SoC-Labs/AHB-QSPI/logical/cache_models/tsmc16/cache_ram.v

module cache_ram #(
    parameter ADDR_W=8
    )(
    input  wire                 CLK,
    input  wire [ADDR_W-1:0]    TAG_ADDR,
    input  wire                 TAG_WE,
    input  wire                 TAG_RD,
    input  wire                 TAG_CS,
    input  wire [10:0]          TAG_WDATA,
    output wire [10:0]          TAG_RDATA,

    input  wire [ADDR_W-1:0]    CLD_ADDR,
    input  wire                 CLD_WE,
    input  wire [3:0]           CLD_RD,
    input  wire [3:0]           CLD_CS,
    input  wire [127:0]         CLD_WDATA,
    output wire [127:0]         CLD_RDATA
);

// ----------------------------------------------------------------------------
// RAM0 Instance for Word index 0
// ----------------------------------------------------------------------------
wire    cs_ram0_word0;
assign  cs_ram0_word0   = CLD_CS[0] & (CLD_WE | CLD_RD[0]);

flash_cache_data data_ram_0_word_0_i (
    .CENY(),
    .GWENY(),
    .AY(),
    .Q(CLD_RDATA[31:0]),
    .SO(),
    .PRDYN(),

    .CLK(CLK),
    .CEN(~cs_ram0_word0),
    .GWEN(~CLD_WE),
    .A(CLD_ADDR),
    .D(CLD_WDATA[31:0]),
    .STOV(1'b0),
    .EMA(3'b011),
    .EMAW(2'b01),
    .EMAS(1'b0),
    .RET1N(1'b1),
    .PGEN(1'b0),
    .TEN(1'b1),
    .TCEN(1'b1),
    .TGWEN(1'b1),
    .TA(8'd0),
    .TD(32'd0),
    .SI(2'b00),
    .SE(1'b0),
    .DFTRAMBYP(1'b0),
    .RET2N(1'b1)
);

// ----------------------------------------------------------------------------
// RAM0 Instance for Word index 1
// ----------------------------------------------------------------------------
wire    cs_ram0_word1;
assign  cs_ram0_word1   = CLD_CS[1] & (CLD_WE | CLD_RD[1]);

flash_cache_data data_ram_0_word_1_i (
    .CENY(),
    .GWENY(),
    .AY(),
    .Q(CLD_RDATA[63:32]),
    .SO(),
    .PRDYN(),

    .CLK(CLK),
    .CEN(~cs_ram0_word1),
    .GWEN(~CLD_WE),
    .A(CLD_ADDR),
    .D(CLD_WDATA[63:32]),
    .STOV(1'b0),
    .EMA(3'b011),
    .EMAW(2'b01),
    .EMAS(1'b0),
    .RET1N(1'b1),
    .PGEN(1'b0),
    .TEN(1'b1),
    .TCEN(1'b1),
    .TGWEN(1'b1),
    .TA(8'd0),
    .TD(32'd0),
    .SI(2'b00),
    .SE(1'b0),
    .DFTRAMBYP(1'b0),
    .RET2N(1'b1)
);

// ----------------------------------------------------------------------------
// RAM0 Instance for Word index 2
// ----------------------------------------------------------------------------
wire    cs_ram0_word2;
assign  cs_ram0_word2   = CLD_CS[2] & (CLD_WE | CLD_RD[2]);

flash_cache_data data_ram_0_word_2_i (
    .CENY(),
    .GWENY(),
    .AY(),
    .Q(CLD_RDATA[95:64]),
    .SO(),
    .PRDYN(),

    .CLK(CLK),
    .CEN(~cs_ram0_word2),
    .GWEN(~CLD_WE),
    .A(CLD_ADDR),
    .D(CLD_WDATA[95:64]),
    .STOV(1'b0),
    .EMA(3'b011),
    .EMAW(2'b01),
    .EMAS(1'b0),
    .RET1N(1'b1),
    .PGEN(1'b0),
    .TEN(1'b1),
    .TCEN(1'b1),
    .TGWEN(1'b1),
    .TA(8'd0),
    .TD(32'd0),
    .SI(2'b00),
    .SE(1'b0),
    .DFTRAMBYP(1'b0),
    .RET2N(1'b1)
);

// ----------------------------------------------------------------------------
// RAM0 Instance for Word index 3
// ----------------------------------------------------------------------------
wire    cs_ram0_word3;
assign  cs_ram0_word3   = CLD_CS[3] & (CLD_WE | CLD_RD[3]);

flash_cache_data data_ram_0_word_3_i (
    .CENY(),
    .GWENY(),
    .AY(),
    .Q(CLD_RDATA[127:96]),
    .SO(),
    .PRDYN(),

    .CLK(CLK),
    .CEN(~cs_ram0_word3),
    .GWEN(~CLD_WE),
    .A(CLD_ADDR),
    .D(CLD_WDATA[127:96]),
    .STOV(1'b0),
    .EMA(3'b011),
    .EMAW(2'b01),
    .EMAS(1'b0),
    .RET1N(1'b1),
    .PGEN(1'b0),
    .TEN(1'b1),
    .TCEN(1'b1),
    .TGWEN(1'b1),
    .TA(8'd0),
    .TD(32'd0),
    .SI(2'b00),
    .SE(1'b0),
    .DFTRAMBYP(1'b0),
    .RET2N(1'b1)
);

// ----------------------------------------------------------------------------
// TAG RAM 0 Instance
// ----------------------------------------------------------------------------
wire    cs_tag0;
assign  cs_tag0         = TAG_CS & (TAG_WE | TAG_RD);

flash_cache_tag tag_ram_0_i (
    .CENY(),
    .GWENY(),
    .AY(),
    .Q(TAG_RDATA),
    .SO(),
    .PRDYN(),

    .CLK(CLK),
    .CEN(~cs_tag0),
    .GWEN(~TAG_WE),
    .A(TAG_ADDR),
    .D(TAG_WDATA),
    .STOV(1'b0),
    .EMA(3'b011),
    .EMAW(2'b01),
    .EMAS(1'b0),
    .RET1N(1'b1),
    .PGEN(1'b0),
    .TEN(1'b1),
    .TCEN(1'b1),
    .TGWEN(1'b1),
    .TA(8'd0),
    .TD(11'd0),
    .SI(2'b00),
    .SE(1'b0),
    .DFTRAMBYP(1'b0),
    .RET2N(1'b1)
);



endmodule
