SoC-Labs/AHB-QSPI/uvm/ahb_qspi/agents/qspi_monitor/qspi_monitor_if.sv

///////////////////////////////////////////////////////////////////////////////
// qspi_monitor_if.sv
///////////////////////////////////////////////////////////////////////////////
// Passive interface for observing the QSPI bus signals.
///////////////////////////////////////////////////////////////////////////////

interface qspi_monitor_if;

  logic       sclk;
  logic       csn;
  logic [3:0] io;      // Directly connected to the bidirectional QSPI_IO bus

endinterface
