SoC-Labs/AHB-QSPI/verif/cocotb/ahb_qspi_tests.py

import logging

from numpy import random

import cocotb
from cocotb.clock import Clock
from cocotb.triggers import Timer, ClockCycles

from cocotbext.ahb import AHBLiteMaster, AHBBus

from SST26VF064B import *
from SST26VF064B import poll_busy_clear, POLL_TIMEOUT_CYCLES, _flash_cmd_byte

QSPI_CONFIG_ADDR = 0x0
CACHE_CONFIG_ADDR = 0x1000

class TB:
    def __init__(self,dut):
        self.dut = dut
        
        self.log = logging.getLogger("cocotb.tb")
        self.log.setLevel(logging.DEBUG)
        self.dut.HRESETn.setimmediatevalue(0)
        cocotb.start_soon(Clock(dut.HCLK, 10, units="ns").start())
        self.config_ahb_master = AHBLiteMaster(AHBBus.from_prefix(dut,"config", optional_signals = {"hsel":"HSEL", "hready_in":"HREADY_IN", "hburst":"HBURST"}), dut.HCLK, dut.HRESETn, 5000)
        self.data_ahb_master = AHBLiteMaster(AHBBus.from_prefix(dut,"data", optional_signals = {"hsel":"HSEL", "hready_in":"HREADY_IN", "hburst":"HBURST"}), dut.HCLK, dut.HRESETn, 5000)

    async def cycle_reset(self):
        await ClockCycles(self.dut.HCLK,1)
        await Timer(time=4.5, units='ns')
        self.dut.HRESETn.setimmediatevalue(0)
        await ClockCycles(self.dut.HCLK,40)
        await Timer(time=4.5, units='ns')
        self.dut.HRESETn.setimmediatevalue(1)
        await ClockCycles(self.dut.HCLK,10)
            

    
async def CACHE_READ(dut,tb):
    data = await tb.data_ahb_master.read(0x00,4)
    return int(data[0]['data'],16)   

@cocotb.test()
async def APB_reg_tests(dut):
    tb = TB(dut)
    await tb.cycle_reset()
    
    tb.log.info("Read ID of QSPI Core")
    PIDR=[0x00, 0x00, 0x00, 0x00, 0x59, 0x16, 0x15, 0x00]
    for i in range(0,8):
        PIDr_temp = await tb.config_ahb_master.read(0xFD0 + i*4,4)
        tb.log.info("PIDR %d = %x",i,int(PIDr_temp[0]['data'],16))
        assert int(PIDr_temp[0]['data'],16) == PIDR[i]
    CIDR=[0x50, 0x51, 0x4C, 0x53]
    for i in range(0,4):
        CIDR_temp = await tb.config_ahb_master.read(0xFF0 + i*4,4)
        tb.log.info("CIDR %d = %x",i,int(CIDR_temp[0]['data'],16))
        assert int(CIDR_temp[0]['data'],16) == CIDR[i]

    tb.log.info("Test REG12")
    await tb.config_ahb_master.write(0x30,0xFFFFFFFF)
    reg12 = await tb.config_ahb_master.read(0x30,4)
    assert int(reg12[0]['data'],16) == 0xFFFFFFFF

    tb.log.info("Test REG0")
    await tb.config_ahb_master.write(0x00,0xFFFFFFFF)
    reg0 = await tb.config_ahb_master.read(0x00,4)
    assert int(reg0[0]['data'],16) == 0xFFFFFFFF

    tb.log.info("Test REG1")
    await tb.config_ahb_master.write(0x04,0xFFFFFFFF)
    reg1 = await tb.config_ahb_master.read(0x04,4)
    reg1 =int(reg1[0]['data'],16)
    reg1 = reg1 | 1
    reg1 = reg1 | (1<<8)
    assert reg1 == 0xFFFFFFFF

    tb.log.info("Test REG2")
    await tb.config_ahb_master.write(0x08,0xFFFFFFFF)
    reg2 = await tb.config_ahb_master.read(0x08,4)
    assert int(reg2[0]['data'],16) == 0xFFFFFFFF

    tb.log.info("Test REG3")
    await tb.config_ahb_master.write(0x0C,0xFFFFFFFF)
    reg3 = await tb.config_ahb_master.read(0x0C,4)
    assert int(reg3[0]['data'],16) == 0xFFFFFFFF


@cocotb.test()
async def QSPI_TESTS(dut):  
    tb = TB(dut)
    await tb.cycle_reset()    
    
    tb.log.info("Reset SPI")
    await SPI_RESET(dut, tb)
    
    tb.log.info("Reading JEDIC in SPI mode")
    
    rID = await SPI_READ_JEDIC(dut, tb)
    tb.log.info("Read ID: 0x%x",rID)
    assert rID == ID
    
    tb.log.info("Setting QPI mode")
    await SET_QPI_MODE(dut, tb)
    await tb.config_ahb_master.write(0x00,0x1)
    
    tb.log.info("Reading JEDIC in QPI mode")
    rID = await QPI_READ_JEDIC(dut, tb)
    tb.log.info("Read ID: 0x%x",rID)
    assert rID == ID

    tb.log.info("Enable Write")
    await SPI_WRITE_ENABLE(dut, tb)
    SPI_STAT = await QPI_READ_STAT_REG(dut, tb)
    WEL = SPI_STAT & (1<<25)
    assert WEL != 0
    
    tb.log.info("Clear Protection and enable Write")
    await SPI_CLR_PROTECTION(dut, tb)
    await SPI_WRITE_ENABLE(dut, tb)
    SPI_STAT = await QPI_READ_STAT_REG(dut, tb)
    WEL = SPI_STAT & (1<<25)
    assert WEL != 0
    
    # Write and read 32-bit word
    tb.log.info("Page program 4x bytes")
    data = [0x18273456]
    await QPI_PAGE_PROGRAM(dut, tb, words=data, n_words=1)
    
    tb.log.info("Read 4x bytes")

    await SPI_WRITE_DISABLE(dut,tb)
    rdata = await QPI_READ_WORDS(dut, tb, n_words=1)
    assert rdata == data
        
    # Write and read 2x 32=bit words
    tb.log.info("Page program 8x bytes")
    data = [0x01234567, 0x89ABCDEF]
    await SPI_WRITE_ENABLE(dut, tb)
    await QPI_PAGE_PROGRAM(dut, tb, addr=0x100, words=data, n_words=2)
    
    tb.log.info("Read 8x bytes")
    await SPI_WRITE_DISABLE(dut,tb)
    rdata = await QPI_READ_WORDS(dut, tb, addr=0x100, n_words=2)
    assert rdata == data

    # Write and read 3x 32=bit words
    tb.log.info("Page program 12x bytes")
    data = [0x13243546, 0x97867564, 0x01234567]
    await SPI_WRITE_ENABLE(dut, tb)
    await QPI_PAGE_PROGRAM(dut, tb, addr=0x200, words=data, n_words=3)
    
    await SPI_WRITE_DISABLE(dut,tb)
    tb.log.info("Read 12x bytes")
    rdata = await QPI_READ_WORDS(dut, tb, addr=0x200, n_words=3)
    assert rdata == data

    # Write and read 4x 32=bit words
    tb.log.info("Page program 16x bytes")
    data = [0x13243546, 0x97867564, 0x89ABCDEF, 0x01234567]
    await SPI_WRITE_ENABLE(dut, tb)
    await QPI_PAGE_PROGRAM(dut, tb, addr=0x300, words=data, n_words=4)
    
    tb.log.info("Read 16x bytes")
    await SPI_WRITE_DISABLE(dut,tb)
    rdata = await QPI_READ_WORDS(dut, tb, addr=0x300, n_words=4)
    assert rdata == data
    
    for i in range(1,16):
        tb.log.info("Read %d bytes",i)
        rdata = await QPI_READ_BYTES(dut,tb,addr=0x300,n_bytes=i)

    tb.log.info("SPI write STATUS register")
    await SPI_WRITE_STATUS(dut, tb)

    # Test untested transitions in QPI
    tb.log.info("Test MODE to DATA_I transition")
    await SPI_MODE_TO_DATA(dut,tb,write=0,read=1)

    tb.log.info("Test MODE to DATA_O transition")
    await SPI_MODE_TO_DATA(dut,tb,write=1,read=0)

    tb.log.info("Test DUMMY to DATA_O transition")
    await SPI_DUMMY_TO_DATAO(dut,tb)

    tb.log.info("Test address to IDLE transition")
    await SPI_ADDR_TO_IDLE(dut, tb, addr=0xFFFFFF)

    tb.log.info("Test DUMMY to IDLE transition")
    await SPI_DUMMY_TO_IDLE(dut, tb)
    
    tb.log.info("Test MODE to IDLE transition")
    await SPI_MODE_TO_IDLE(dut, tb)

    tb.log.info("Exit QPI MODE")
    await LEAVE_QPI_MODE(dut, tb)
    await tb.config_ahb_master.write(0x00,0x0)
    
    tb.log.info("Read 16x bytes (SPI)")
    rdata = await SPI_READ_WORDS(dut, tb, addr=0x300, n_words=4)
    assert rdata == data
    
    await tb.config_ahb_master.write(0x34, 0x02)
    tb.log.info("Clock divider changed")

    tb.log.info("Read 16x bytes (SPI) Slow")
    rdata = await SPI_READ_WORDS_SLOW(dut, tb, addr=0x300, n_words=4)
    assert rdata == data
    
    tb.log.info("SPI write STATUS register")
    await SPI_WRITE_STATUS(dut, tb)

    # Test untested transitions in SPI
    tb.log.info("Test MODE to DATA_I transition")
    await SPI_MODE_TO_DATA(dut,tb,write=0,read=1)

    tb.log.info("Test MODE to DATA_O transition")
    await SPI_MODE_TO_DATA(dut,tb,write=1,read=0)

    tb.log.info("Test DUMMY to DATA_O transition")
    await SPI_DUMMY_TO_DATAO(dut,tb)

    tb.log.info("Test address to IDLE transition")
    await SPI_ADDR_TO_IDLE(dut, tb, addr=0xFFFFFF)

    tb.log.info("Test DUMMY to IDLE transition")
    await SPI_DUMMY_TO_IDLE(dut, tb)
    
    tb.log.info("Test MODE to IDLE transition")
    await SPI_MODE_TO_IDLE(dut, tb)



    await tb.config_ahb_master.write(0x34, 0x1F)
    tb.log.info("Clock divider changed")

    tb.log.info("Read 16x bytes (SPI) Very Slow")
    rdata = await SPI_READ_WORDS_SLOW(dut, tb, addr=0x300, n_words=4)
    assert rdata == data

    


@cocotb.test()
async def QSPI_READ_TESTS(dut):  
    n_reads = 64
    base_addr = 0x400

    tb = TB(dut)
    await tb.cycle_reset()
    
    tb.log.info("Reset SPI")
    await SPI_RESET(dut, tb)
    
    tb.log.info("Reading JEDIC in SPI mode")
    ID = 0x4326BF00
    rID = await SPI_READ_JEDIC(dut, tb)
    assert rID == ID
    
    tb.log.info("Setting QPI mode")
    await SET_QPI_MODE(dut, tb)
    await tb.config_ahb_master.write(0x00,0x1)
    
    await tb.config_ahb_master.write(0x34, 0x00)
    tb.log.info("Clock divider changed CLK=100MHz")

    tb.log.info("Reading JEDIC in QPI mode")
    rID = await QPI_READ_JEDIC(dut, tb)
    assert rID == ID
    
    await SPI_WRITE_ENABLE(dut, tb)
    tb.log.info("Clear Protection and enable Write")
    await SPI_CLR_PROTECTION(dut, tb)
    
    tb.log.info("Page program 512x 16-bytes")
    data = random.randint(4294967295, size=4*n_reads)
    data = data.tolist()
    for i in range(0,n_reads):
        addr = i*16 + base_addr
        await SPI_WRITE_ENABLE(dut, tb)
        SPI_STAT = await QPI_READ_STAT_REG(dut, tb)
        WEL = SPI_STAT & (1<<25)
        assert WEL != 0
        await QPI_PAGE_PROGRAM(dut, tb, addr=addr, words=data[(i*4):(i*4+4)], n_words=4)
        await SPI_WRITE_DISABLE(dut,tb)
        tb.log.info("Programmed %d words", i)
    
    await SPI_WRITE_DISABLE(dut,tb)

    tb.log.info("Read 16x bytes over APB")
    rDATA = await QPI_READ_WORDS(dut, tb, addr=0x10000, n_words=4, cont_read=True)
    
    tb.log.info("Set Continuous Read mode")
    QSPI_CTRL_REG = await tb.config_ahb_master.read(0x00,4)
    QSPI_CTRL_REG = int(QSPI_CTRL_REG[0]['data'],16)
    QSPI_CTRL_REG = QSPI_CTRL_REG | (1<<25)
    await tb.config_ahb_master.write(0x00, QSPI_CTRL_REG)    
    
    tb.log.info("Read %d x 16-bytes over APB in continous read mode",n_reads)
    start_time = cocotb.utils.get_sim_time(units='ns')
    for i in range(0,n_reads):
        addr = i*16 + base_addr
        rDATA = await QPI_READ_WORDS(dut, tb, addr=addr, n_words=4, cont_read=True)
        assert rDATA==data[(i*4):(i*4+4)]
        tb.log.info("Read %d words", i)

    end_time = cocotb.utils.get_sim_time(units='ns')
    dt= end_time-start_time

    
    tb.log.info("Set AHB Mode")
    QSPI_CTRL_REG = await tb.config_ahb_master.read(0x00,4)
    QSPI_CTRL_REG = int(QSPI_CTRL_REG[0]['data'],16)
    QSPI_CTRL_REG = QSPI_CTRL_REG | (1<<8)
    await tb.config_ahb_master.write(0x00, QSPI_CTRL_REG)

    QSPI_AHB_CMD_REG = (4<<12) + 0x0B
    await tb.config_ahb_master.write(0x30, QSPI_AHB_CMD_REG)


    tb.log.info("Configure Cache")
    CACHE_STATUS_tmp = await tb.config_ahb_master.read(CACHE_CONFIG_ADDR+0x04,4)
    CACHE_STATUS = int(CACHE_STATUS_tmp[0]['data'],16)
    assert CACHE_STATUS==0  
    
    await tb.config_ahb_master.write(CACHE_CONFIG_ADDR, 0x1)

    CACHE_CONFIG_tmp = await tb.config_ahb_master.read(CACHE_CONFIG_ADDR,4)
    CACHE_CONFIG = int(CACHE_CONFIG_tmp[0]['data'],16)
    assert CACHE_CONFIG == 0x1

    CACHE_STATUS_tmp = await tb.config_ahb_master.read(CACHE_CONFIG_ADDR+0x04,4)
    CACHE_STATUS = int(CACHE_STATUS_tmp[0]['data'],16)
    while((CACHE_STATUS&(0x3))!=2):
        CACHE_STATUS_tmp = await tb.config_ahb_master.read(CACHE_CONFIG_ADDR+0x00,4)
        CACHE_STATUS_tmp = await tb.config_ahb_master.read(CACHE_CONFIG_ADDR+0x04,4)
        CACHE_STATUS = int(CACHE_STATUS_tmp[0]['data'],16)
        await Timer(time=10, units='us')
    # Re-align to HCLK before driving the data port. A Timer that is a
    # multiple of the clock period ends exactly on a rising edge, and the
    # master's first address phase then races that edge: it can be written
    # and withdrawn in the same time step, so the slave never sees it. The
    # race was masked while ahb_qspi_interface.HRDATA had no reset (X made
    # the cocotbext master wait); HRDATA is reset since the H-PIPE fix.
    await ClockCycles(dut.HCLK, 1)

    tb.log.info("Read %d x bytes over AHB (uncached)",n_reads*16)
    start_time_uncached = cocotb.utils.get_sim_time(units='ns')
    for i in range(0,n_reads*4):
        rdata = await tb.data_ahb_master.read(i*4 + base_addr,4)
        assert int(rdata[0]['data'],16)==data[i]
    end_time_uncached = cocotb.utils.get_sim_time(units='ns')
    dt_uncached = end_time_uncached - start_time_uncached
    await Timer(time=10, units='us')
    await ClockCycles(dut.HCLK, 1)  # re-align to HCLK (see above)
    rdata = await tb.data_ahb_master.read(base_addr,4)
    
    tb.log.info("Read %d x bytes over AHB (cached)",n_reads*16)
    start_time_cached = cocotb.utils.get_sim_time(units='ns')
    for i in range(0,n_reads*4):
        rdata = await tb.data_ahb_master.read(i*4 + base_addr,4)
        assert int(rdata[0]['data'],16)==data[i]
    end_time_cached = cocotb.utils.get_sim_time(units='ns')
    dt_cached = end_time_cached - start_time_cached

    tb.log.info("Read over AHB full address range (cached)")
    for i in range(0, 0xFFFFFF, 0x1000):
        rdata = await tb.data_ahb_master.read(i, 4)

    await tb.config_ahb_master.write(0x34, 0x05)
    tb.log.info("Clock divider changed")

    await tb.config_ahb_master.write(CACHE_CONFIG_ADDR, 0x0)
    tb.log.info("Disable Cache")
    CACHE_CONFIG_tmp = await tb.config_ahb_master.read(CACHE_CONFIG_ADDR,4)
    CACHE_CONFIG = int(CACHE_CONFIG_tmp[0]['data'],16)
    assert CACHE_CONFIG == 0x0

    CACHE_STATUS_tmp = await tb.config_ahb_master.read(CACHE_CONFIG_ADDR+0x04,4)
    CACHE_STATUS = int(CACHE_STATUS_tmp[0]['data'],16)
    while((CACHE_STATUS&(0x3))!=0):
        CACHE_STATUS_tmp = await tb.config_ahb_master.read(CACHE_CONFIG_ADDR+0x00,4)
        CACHE_STATUS_tmp = await tb.config_ahb_master.read(CACHE_CONFIG_ADDR+0x04,4)
        CACHE_STATUS = int(CACHE_STATUS_tmp[0]['data'],16)
        await Timer(time=10, units='us')
    await ClockCycles(dut.HCLK, 1)  # re-align to HCLK (see above)

    rdata = await tb.data_ahb_master.read(base_addr,4)

    tb.log.info("Read 512x 16-bytes over AHB (uncached)")
    start_time_slow = cocotb.utils.get_sim_time(units='ns')
    for i in range(0,n_reads*4):
        rdata = await tb.data_ahb_master.read(i*4+ base_addr,4)
        assert int(rdata[0]['data'],16)==data[i]
    end_time_slow = cocotb.utils.get_sim_time(units='ns')
    dt_slow = end_time_slow - start_time_slow

    tb.log.info("Try write over AHB, expect ERROR")
    resp = await tb.data_ahb_master.write(0x000,0xFFFFFFFF)
    tb.log.info(resp[0]['resp'])

    await tb.config_ahb_master.write(0x00, 0x01)

    await tb.config_ahb_master.write(0x08, 0x0FF)
    await tb.config_ahb_master.write(0x08, 0x1FF)
    await tb.config_ahb_master.write(0x08, 0x0FF)
    await tb.config_ahb_master.write(0x08, 0x1FF)
    tb.log.info("Time taken = %f", dt)
    BW = n_reads*4/(dt*1e-3)
    BW_uncached = n_reads*4/(dt_uncached*1e-3)
    BW_cached = n_reads*4/(dt_cached*1e-3)
    BW_slow = n_reads*4/(dt_slow*1e-3)
    
    tb.log.info("dt APB: %f ns", dt)
    tb.log.info("dt caching: %f ns", dt_uncached)
    tb.log.info("dt cached: %f ns", dt_cached)
    tb.log.info("dt slow: %f ns", dt_slow)


    tb.log.info("Bandwidth APB: %f MB/s", BW)
    tb.log.info("Bandwidth caching: %f MB/s", BW_uncached)
    tb.log.info("Bandwidth cached: %f MB/s", BW_cached)
    tb.log.info("Bandwidth slow: %f MB/s", BW_slow)


@cocotb.test()
async def CACHE_CONFIG(dut):
    tb = TB(dut)
    await tb.cycle_reset()
    data = await tb.config_ahb_master.read(CACHE_CONFIG_ADDR,4)
    # After reset CCR register should = 0x40
    assert int(data[0]['data'],16) == 0x40
    data = await tb.config_ahb_master.read(CACHE_CONFIG_ADDR+0x20,4)
    print(data)

@cocotb.test()
async def AHB_BAD_BEHAVIOUR(dut):
    tb = TB(dut)
    await tb.cycle_reset()

    tb.log.info("Try write over AHB, expect ERROR")
    try:
        resp = await tb.data_ahb_master.write(0x000,0xCAFECAFE)
        tb.log.info("Write response: %s", resp[0]['resp'])
        assert resp[0]['resp'] == 'ERROR', f"AHB write should return ERROR, got {resp[0]['resp']}"
    except Exception as e:
        tb.log.info("AHB write raised exception (expected for error response): %s", type(e).__name__)

    tb.log.info("Try read over AHB when in APB mode, expect ERROR")
    try:
        data = await tb.data_ahb_master.read(0x100,4)
        tb.log.info("Read response: %s", data[0]['resp'])
        assert data[0]['resp'] == 'ERROR', f"AHB read without XIP should return ERROR, got {data[0]['resp']}"
    except Exception as e:
        tb.log.info("AHB read raised exception (expected for error response): %s", type(e).__name__)


@cocotb.test()
async def test_bug1_rdata_latch(dut):
    """Test BUG-1: QSPI_RDATA latch in always_comb.

    The QSPI_RDATA combinational block has no else clause when HRESETn=1
    and QSPI_nCS=0, causing QSPI_RDATA to latch its previous value.
    This test performs two reads with different data sizes and values,
    verifying QSPI_RDATA updates correctly each time and is zero after reset.
    """
    tb = TB(dut)
    await tb.cycle_reset()

    # After reset, QSPI_RDATA should be 0
    rdata_reg0 = await tb.config_ahb_master.read(0x10, 4)
    rdata_val = int(rdata_reg0[0]['data'], 16)
    tb.log.info("QSPI_RDATA word0 after reset: 0x%08x", rdata_val)
    assert rdata_val == 0, f"QSPI_RDATA should be 0 after reset, got 0x{rdata_val:08x}"

    # Initialize flash
    tb.log.info("Reset SPI")
    await SPI_RESET(dut, tb)

    tb.log.info("Setting QPI mode")
    await SET_QPI_MODE(dut, tb)
    await tb.config_ahb_master.write(0x00, 0x1)

    tb.log.info("Enable Write")
    await SPI_WRITE_ENABLE(dut, tb)

    tb.log.info("Clear Protection")
    await SPI_CLR_PROTECTION(dut, tb)

    # Write known data to two different addresses with different sizes
    # Address 0x1000: 1 word (4 bytes)
    data_a = [0xDEADBEEF]
    await SPI_WRITE_ENABLE(dut, tb)
    await QPI_PAGE_PROGRAM(dut, tb, addr=0x1000, words=data_a, n_words=1)
    tb.log.info("Programmed 0x%08x at address 0x1000", data_a[0])

    # Address 0x1100: 2 words (8 bytes)
    data_b = [0x12345678, 0xCAFEBABE]
    await SPI_WRITE_ENABLE(dut, tb)
    await QPI_PAGE_PROGRAM(dut, tb, addr=0x1100, words=data_b, n_words=2)
    tb.log.info("Programmed 0x%08x 0x%08x at address 0x1100", data_b[0], data_b[1])

    # First read: 1 word from address 0x1000
    await SPI_WRITE_DISABLE(dut, tb)
    tb.log.info("Read 1 word from address 0x1000")
    rdata1 = await QPI_READ_WORDS(dut, tb, addr=0x1000, n_words=1)
    tb.log.info("Read data 1: 0x%08x (expected 0x%08x)", rdata1[0], data_a[0])
    assert rdata1 == data_a, f"First read mismatch: got {rdata1}, expected {data_a}"

    # Second read: 2 words from address 0x1100 (different byte count exercises
    # the QSPI_RDATA mux with a different QSPI_N_RW_BYTES value)
    tb.log.info("Read 2 words from address 0x1100")
    rdata2 = await QPI_READ_WORDS(dut, tb, addr=0x1100, n_words=2)
    tb.log.info("Read data 2: 0x%08x 0x%08x (expected 0x%08x 0x%08x)",
                rdata2[0], rdata2[1], data_b[0], data_b[1])
    assert rdata2 == data_b, f"Second read mismatch: got {rdata2}, expected {data_b}"

    # Third read: re-read address 0x1000 to confirm RDATA updates back
    tb.log.info("Re-read 1 word from address 0x1000")
    rdata3 = await QPI_READ_WORDS(dut, tb, addr=0x1000, n_words=1)
    tb.log.info("Read data 3: 0x%08x (expected 0x%08x)", rdata3[0], data_a[0])
    assert rdata3 == data_a, f"Third read mismatch: got {rdata3}, expected {data_a}"

    tb.log.info("BUG-1 test PASSED: QSPI_RDATA updates correctly across reads")


@cocotb.test()
async def test_bug2_enable_ack_latch(dut):
    """Test BUG-2: QSPI_ENABLE_ACK not assigned in all FSM states.

    QSPI_ENABLE_ACK is only assigned in IDLE (else branch), NO_FETCH, OP,
    and ADDR states. It is NOT assigned in MODE, DUMMY, DATA_O, DATA_I,
    creating a latch. This test exercises transactions that pass through
    MODE, DUMMY, and DATA_I states and verifies QSPI_ENABLE_ACK behaves
    correctly (deasserts to allow reg2[8] to clear so the controller
    completes properly).
    """
    tb = TB(dut)
    await tb.cycle_reset()

    # Initialize flash
    tb.log.info("Reset SPI")
    await SPI_RESET(dut, tb)

    tb.log.info("Setting QPI mode")
    await SET_QPI_MODE(dut, tb)
    await tb.config_ahb_master.write(0x00, 0x1)

    tb.log.info("Enable Write and Clear Protection")
    await SPI_WRITE_ENABLE(dut, tb)
    await SPI_CLR_PROTECTION(dut, tb)

    # Program test data
    data = [0xA5A5A5A5, 0x5A5A5A5A, 0x12345678, 0x9ABCDEF0]
    await SPI_WRITE_ENABLE(dut, tb)
    await QPI_PAGE_PROGRAM(dut, tb, addr=0x2000, words=data, n_words=4)
    tb.log.info("Programmed 4 words at address 0x2000")

    await SPI_WRITE_DISABLE(dut, tb)

    # Test 1: Read with dummy cycles (exercises DUMMY and DATA_I states)
    # Standard QPI fast read (0x0B) with 6 dummy cycles, 4 words
    tb.log.info("Test read with dummy cycles (DUMMY -> DATA_I path)")
    rdata = await QPI_READ_WORDS(dut, tb, addr=0x2000, n_words=4)
    tb.log.info("Read data: %s", [hex(x) for x in rdata])
    assert rdata == data, f"Read with dummy cycles failed: got {rdata}, expected {data}"

    # After transaction completes, verify QSPI is no longer busy
    # (QSPI_ENABLE_ACK must have been properly handled)
    status = await tb.config_ahb_master.read(0x04, 4)
    busy = int(status[0]['data'], 16) & 1
    tb.log.info("QSPI busy after dummy-cycle read: %d", busy)
    assert busy == 0, "QSPI should not be busy after transaction completes"

    # Test 2: Read with continuous read mode (exercises MODE -> DUMMY -> DATA_I)
    # Enable continuous read mode with mode code 0xA0
    tb.log.info("Test read with continuous read mode (MODE -> DUMMY -> DATA_I path)")
    QSPI_CTRL_REG = await tb.config_ahb_master.read(0x00, 4)
    QSPI_CTRL_REG = int(QSPI_CTRL_REG[0]['data'], 16)
    QSPI_CTRL_REG = QSPI_CTRL_REG | ((0xA0 << 16) + (1 << 24))
    await tb.config_ahb_master.write(0x00, QSPI_CTRL_REG)

    rdata2 = await QPI_READ_WORDS(dut, tb, addr=0x2000, n_words=4, cont_read=True)
    tb.log.info("Read data (cont): %s", [hex(x) for x in rdata2])
    assert rdata2 == data, f"Continuous read failed: got {rdata2}, expected {data}"

    # Check busy flag cleared
    status = await tb.config_ahb_master.read(0x04, 4)
    busy = int(status[0]['data'], 16) & 1
    tb.log.info("QSPI busy after continuous read: %d", busy)
    assert busy == 0, "QSPI should not be busy after continuous read completes"

    # Test 3: MODE -> DATA_I transition (no dummy cycles, with mode code)
    tb.log.info("Test MODE -> DATA_I transition")
    await SPI_MODE_TO_DATA(dut, tb, write=0, read=1)

    # Check busy flag cleared
    status = await tb.config_ahb_master.read(0x04, 4)
    busy = int(status[0]['data'], 16) & 1
    tb.log.info("QSPI busy after MODE->DATA_I: %d", busy)
    assert busy == 0, "QSPI should not be busy after MODE->DATA_I completes"

    # Test 4: DUMMY -> DATA_O transition
    tb.log.info("Test DUMMY -> DATA_O transition")
    await SPI_DUMMY_TO_DATAO(dut, tb)

    # Check busy flag cleared
    status = await tb.config_ahb_master.read(0x04, 4)
    busy = int(status[0]['data'], 16) & 1
    tb.log.info("QSPI busy after DUMMY->DATA_O: %d", busy)
    assert busy == 0, "QSPI should not be busy after DUMMY->DATA_O completes"

    tb.log.info("BUG-2 test PASSED: QSPI_ENABLE_ACK handled correctly through MODE/DUMMY/DATA states")


@cocotb.test()
async def test_bug3_no_cmd_last_addr(dut):
    """Test BUG-3: last_QSPI_ADDR stateful assignment in always_comb.

    last_QSPI_ADDR is assigned with a blocking assignment in the always_comb
    FSM block (ADDR state), creating a latch. This variable is used by the
    NO_CMD optimization: when QSPI_NO_CMD=1 and the address matches
    last_QSPI_ADDR, the FSM skips to NO_FETCH instead of ADDR.

    Test sequence:
    1. Normal QPI read to address A (sets last_QSPI_ADDR = A)
    2. Enable NO_CMD mode
    3. Read same address A -> should use NO_FETCH path
    4. Read different address B -> should use ADDR path
    5. Verify correct data in all cases
    """
    tb = TB(dut)
    await tb.cycle_reset()

    # Initialize flash
    tb.log.info("Reset SPI")
    await SPI_RESET(dut, tb)

    tb.log.info("Setting QPI mode")
    await SET_QPI_MODE(dut, tb)
    await tb.config_ahb_master.write(0x00, 0x1)

    tb.log.info("Enable Write and Clear Protection")
    await SPI_WRITE_ENABLE(dut, tb)
    await SPI_CLR_PROTECTION(dut, tb)

    # Program data at two different addresses
    addr_a = 0x3000
    addr_b = 0x3100
    data_a = [0x11223344, 0x55667788, 0x99AABBCC, 0xDDEEFF00]
    data_b = [0xAAAAAAAA, 0xBBBBBBBB, 0xCCCCCCCC, 0xDDDDDDDD]

    await SPI_WRITE_ENABLE(dut, tb)
    await QPI_PAGE_PROGRAM(dut, tb, addr=addr_a, words=data_a, n_words=4)
    tb.log.info("Programmed 4 words at address 0x%06x", addr_a)

    await SPI_WRITE_ENABLE(dut, tb)
    await QPI_PAGE_PROGRAM(dut, tb, addr=addr_b, words=data_b, n_words=4)
    tb.log.info("Programmed 4 words at address 0x%06x", addr_b)

    await SPI_WRITE_DISABLE(dut, tb)

    # Step 1: Normal QPI read to address A (this sets last_QSPI_ADDR = A)
    # Use continuous read mode so the controller goes through MODE state
    # and sets up for NO_CMD usage
    tb.log.info("Step 1: Normal QPI read to address 0x%06x (sets last_QSPI_ADDR)", addr_a)
    rdata1 = await QPI_READ_WORDS(dut, tb, addr=addr_a, n_words=4, cont_read=True)
    tb.log.info("Read data: %s", [hex(x) for x in rdata1])
    assert rdata1 == data_a, f"Step 1 read mismatch: got {rdata1}, expected {data_a}"

    # Step 2: Enable NO_CMD mode (bit 25 of reg0)
    tb.log.info("Step 2: Enable NO_CMD mode")
    QSPI_CTRL_REG = await tb.config_ahb_master.read(0x00, 4)
    QSPI_CTRL_REG = int(QSPI_CTRL_REG[0]['data'], 16)
    QSPI_CTRL_REG = QSPI_CTRL_REG | (1 << 25)
    await tb.config_ahb_master.write(0x00, QSPI_CTRL_REG)
    tb.log.info("reg0 = 0x%08x (NO_CMD enabled)", QSPI_CTRL_REG)

    # Step 3: Read same address A with NO_CMD -> should use NO_FETCH path
    tb.log.info("Step 3: Read same address 0x%06x with NO_CMD (expect NO_FETCH path)", addr_a)
    rdata2 = await QPI_READ_WORDS(dut, tb, addr=addr_a, n_words=4, cont_read=True)
    tb.log.info("Read data (same addr, NO_CMD): %s", [hex(x) for x in rdata2])
    assert rdata2 == data_a, f"Step 3 read mismatch (NO_FETCH path): got {rdata2}, expected {data_a}"

    # Step 4: Read different address B with NO_CMD -> should use ADDR path
    tb.log.info("Step 4: Read different address 0x%06x with NO_CMD (expect ADDR path)", addr_b)
    rdata3 = await QPI_READ_WORDS(dut, tb, addr=addr_b, n_words=4, cont_read=True)
    tb.log.info("Read data (diff addr, NO_CMD): %s", [hex(x) for x in rdata3])
    assert rdata3 == data_b, f"Step 4 read mismatch (ADDR path): got {rdata3}, expected {data_b}"

    # Step 5: Read address B again with NO_CMD -> should use NO_FETCH again
    # (last_QSPI_ADDR should now be B)
    tb.log.info("Step 5: Read same address 0x%06x again with NO_CMD (expect NO_FETCH)", addr_b)
    rdata4 = await QPI_READ_WORDS(dut, tb, addr=addr_b, n_words=4, cont_read=True)
    tb.log.info("Read data (same addr B, NO_CMD): %s", [hex(x) for x in rdata4])
    assert rdata4 == data_b, f"Step 5 read mismatch: got {rdata4}, expected {data_b}"

    # Step 6: Go back to address A with NO_CMD -> should use ADDR path
    tb.log.info("Step 6: Read address 0x%06x with NO_CMD (expect ADDR path)", addr_a)
    rdata5 = await QPI_READ_WORDS(dut, tb, addr=addr_a, n_words=4, cont_read=True)
    tb.log.info("Read data (back to addr A, NO_CMD): %s", [hex(x) for x in rdata5])
    assert rdata5 == data_a, f"Step 6 read mismatch: got {rdata5}, expected {data_a}"

    # Disable NO_CMD mode
    QSPI_CTRL_REG = QSPI_CTRL_REG & ~(1 << 25)
    await tb.config_ahb_master.write(0x00, QSPI_CTRL_REG)
    tb.log.info("NO_CMD mode disabled")

    tb.log.info("BUG-3 test PASSED: last_QSPI_ADDR and NO_CMD/NO_FETCH work correctly")


# ============================================================================
# New Thorough Tests
# ============================================================================

async def init_qpi(dut, tb):
    """Common init: reset, enter QPI, enable write, clear protection."""
    await tb.cycle_reset()
    await SPI_RESET(dut, tb)
    await SET_QPI_MODE(dut, tb)
    await tb.config_ahb_master.write(0x00, 0x1)
    await SPI_WRITE_ENABLE(dut, tb)
    await SPI_CLR_PROTECTION(dut, tb)


@cocotb.test()
async def test_register_reset_values(dut):
    """Verify all registers return expected default values after reset."""
    tb = TB(dut)
    await tb.cycle_reset()

    checks = [
        (0x00, 0x00000000, "REG0 (Control)"),
        (0x04, 0x00000000, "REG1 (Status)"),
        (0x08, 0x00000000, "REG2 (Command)"),
        (0x0C, 0x00000000, "REG3 (Address)"),
        (0x20, 0x00000000, "REG8 (WDATA0)"),
        (0x24, 0x00000000, "REG9 (WDATA1)"),
        (0x28, 0x00000000, "REG10 (WDATA2)"),
        (0x2C, 0x00000000, "REG11 (WDATA3)"),
        (0x30, 0x00000000, "REG12 (AHB Setup)"),
        (0x34, 0x00000001, "REG13 (CLK Div, default=1)"),
    ]

    for addr, expected, name in checks:
        data = await tb.config_ahb_master.read(addr, 4)
        val = int(data[0]['data'], 16)
        tb.log.info("%s @ 0x%02x = 0x%08x (expected 0x%08x)", name, addr, val, expected)
        assert val == expected, f"{name} reset value mismatch: got 0x{val:08x}, expected 0x{expected:08x}"

    tb.log.info("All register reset values verified")


@cocotb.test()
async def test_register_bit_masking(dut):
    """Write 0xFFFFFFFF to registers, verify only valid bits stored."""
    tb = TB(dut)
    await tb.cycle_reset()

    # REG3 (Address) should mask to 22 bits [21:0]
    await tb.config_ahb_master.write(0x0C, 0xFFFFFFFF)
    data = await tb.config_ahb_master.read(0x0C, 4)
    val = int(data[0]['data'], 16)
    tb.log.info("REG3 write 0xFFFFFFFF readback: 0x%08x", val)
    assert val == 0xFFFFFFFF or val == 0x003FFFFF, \
        f"REG3 unexpected mask: 0x{val:08x}"

    # REG13 (CLK Div) should mask to 5 bits [4:0]
    await tb.config_ahb_master.write(0x34, 0xFFFFFFFF)
    data = await tb.config_ahb_master.read(0x34, 4)
    val = int(data[0]['data'], 16)
    tb.log.info("REG13 write 0xFFFFFFFF readback: 0x%08x", val)
    assert val == 0x1F, f"REG13 should mask to 5 bits, got 0x{val:08x}"

    # REG1[0] (BUSY) is read-only -- write 0xFFFFFFFF, bit 0 should reflect BUSY state (0)
    await tb.config_ahb_master.write(0x04, 0xFFFFFFFF)
    data = await tb.config_ahb_master.read(0x04, 4)
    val = int(data[0]['data'], 16)
    busy_bit = val & 1
    tb.log.info("REG1 write 0xFFFFFFFF readback: 0x%08x, busy=%d", val, busy_bit)
    assert busy_bit == 0, "REG1[0] (BUSY) should be read-only and reflect actual QSPI_BUSY"

    tb.log.info("Register bit masking verified")


@cocotb.test()
async def test_wdata_regs_readback(dut):
    """Verify write data registers (REG8-11) can be written and read back."""
    tb = TB(dut)
    await tb.cycle_reset()

    test_patterns = [0xDEADBEEF, 0xCAFEBABE, 0x12345678, 0x9ABCDEF0]
    wdata_addrs = [0x20, 0x24, 0x28, 0x2C]

    for i, (addr, pattern) in enumerate(zip(wdata_addrs, test_patterns)):
        await tb.config_ahb_master.write(addr, pattern)
        data = await tb.config_ahb_master.read(addr, 4)
        val = int(data[0]['data'], 16)
        tb.log.info("REG%d @ 0x%02x: wrote 0x%08x, read 0x%08x", 8+i, addr, pattern, val)
        assert val == pattern, f"REG{8+i} readback mismatch"

    tb.log.info("Write data registers verified")


@cocotb.test()
async def test_enable_auto_clear(dut):
    """Verify REG2[8] (ENABLE) auto-clears after QSPI_ENABLE_ACK."""
    tb = TB(dut)
    await tb.cycle_reset()
    await SPI_RESET(dut, tb)

    # Write command with enable bit set
    await tb.config_ahb_master.write(0x08, 0x00000006)  # WREN without enable
    await tb.config_ahb_master.write(0x08, 0x00000106)  # Set enable bit [8]

    # Wait for transaction to complete (must use wait_for_irq for CDC timing)
    await wait_for_irq(dut, tb)
    await poll_busy_clear(dut, tb)

    # Read REG2 back -- bit 8 should be cleared
    data = await tb.config_ahb_master.read(0x08, 4)
    val = int(data[0]['data'], 16)
    enable_bit = (val >> 8) & 1
    tb.log.info("REG2 after transaction: 0x%08x, enable=%d", val, enable_bit)
    assert enable_bit == 0, "REG2[8] (ENABLE) should auto-clear after QSPI_ENABLE_ACK"

    tb.log.info("ENABLE auto-clear verified")


@cocotb.test()
async def test_irq_lifecycle(dut):
    """Test IRQ assertion on transaction complete and clearing via REG1[8]."""
    tb = TB(dut)
    await tb.cycle_reset()
    await SPI_RESET(dut, tb)

    # After reset, IRQ should be deasserted
    assert dut.IRQ_QSPI_FINISHED.value == 0, "IRQ should be 0 after reset"

    # Trigger a simple command (WREN)
    await tb.config_ahb_master.write(0x08, 0x00000006)
    await tb.config_ahb_master.write(0x08, 0x00000106)

    # Wait for IRQ to assert
    for _ in range(POLL_TIMEOUT_CYCLES):
        if dut.IRQ_QSPI_FINISHED.value == 1:
            break
        await ClockCycles(dut.HCLK, 1)
    else:
        raise AssertionError("IRQ did not assert after transaction")

    tb.log.info("IRQ asserted after transaction")

    # Clear IRQ by writing REG1[8]
    await tb.config_ahb_master.write(0x04, 0x00000100)
    await ClockCycles(dut.HCLK, 5)
    assert dut.IRQ_QSPI_FINISHED.value == 0, "IRQ should clear after writing REG1[8]"

    # Verify no spurious IRQ within 100 cycles
    for _ in range(100):
        await ClockCycles(dut.HCLK, 1)
        assert dut.IRQ_QSPI_FINISHED.value == 0, "Spurious IRQ detected"

    tb.log.info("IRQ lifecycle verified: assert, clear, no spurious")


@cocotb.test()
async def test_spi_write_and_read(dut):
    """Test page program and readback in SPI mode (not QPI)."""
    tb = TB(dut)
    await tb.cycle_reset()
    await SPI_RESET(dut, tb)

    # Stay in SPI mode (don't call SET_QPI_MODE)
    # QIO_MODE=0 (default after reset)

    await SPI_WRITE_ENABLE(dut, tb)
    await SPI_CLR_PROTECTION(dut, tb)

    # Write 4 words at address 0x4000 in SPI mode
    addr = 0x4000
    data = [0xAABBCCDD, 0x11223344, 0x55667788, 0x99AABB00]

    await SPI_WRITE_ENABLE(dut, tb)

    # Use SPI page program (cmd 0x02)
    await tb.config_ahb_master.write(0x0C, addr)
    for i, word in enumerate(data):
        await tb.config_ahb_master.write(0x20 + i*4, word)

    QSPI_INSTR = 0x02  # PP command
    QSPI_INSTR += (0 << 9)    # read=0
    QSPI_INSTR += (1 << 10)   # write=1
    QSPI_INSTR += (1 << 11)   # addr_en=1
    QSPI_INSTR += (0 << 12)   # dummy=0
    QSPI_INSTR += (15 << 16)  # n_rw_bytes=15 (16 bytes)

    await tb.config_ahb_master.write(0x08, QSPI_INSTR)
    await tb.config_ahb_master.write(0x08, QSPI_INSTR | (1 << 8))

    await wait_for_irq(dut, tb)
    await poll_busy_clear(dut, tb)

    # Wait for flash internal program to complete
    for _ in range(10000):
        SPI_STAT = await SPI_READ_STAT_REG(dut, tb)
        if not (SPI_STAT & (1 << 24)):
            break
        await Timer(time=1, units='us')

    await SPI_WRITE_DISABLE(dut, tb)

    # Read back in SPI mode with fast read (0x0B, 8 dummy cycles)
    rdata = await SPI_READ_WORDS(dut, tb, addr=addr, n_words=4)
    tb.log.info("SPI write/read: wrote %s, read %s",
                [hex(x) for x in data], [hex(x) for x in rdata])
    assert rdata == data, "SPI mode write/read mismatch"

    tb.log.info("SPI mode write and read verified")


@cocotb.test()
async def test_spi_standard_read(dut):
    """Test standard SPI read (cmd 0x03, 0 dummy cycles) vs fast read (0x0B)."""
    tb = TB(dut)
    await init_qpi(dut, tb)

    # Program known data
    addr = 0x5000
    data = [0xFEDCBA98]
    await SPI_WRITE_ENABLE(dut, tb)
    await QPI_PAGE_PROGRAM(dut, tb, addr=addr, words=data, n_words=1)
    await SPI_WRITE_DISABLE(dut, tb)

    # Switch to SPI mode
    await LEAVE_QPI_MODE(dut, tb)
    await tb.config_ahb_master.write(0x00, 0x0)

    # Read with standard read (cmd 0x03, 0 dummy cycles)
    rdata_slow = await SPI_READ_WORDS_SLOW(dut, tb, addr=addr, n_words=1)
    tb.log.info("Standard read (0x03): 0x%08x", rdata_slow[0])
    assert rdata_slow == data, f"Standard read mismatch: got {rdata_slow}"

    # Read with fast read (cmd 0x0B, 8 dummy cycles)
    rdata_fast = await SPI_READ_WORDS(dut, tb, addr=addr, n_words=1)
    tb.log.info("Fast read (0x0B): 0x%08x", rdata_fast[0])
    assert rdata_fast == data, f"Fast read mismatch: got {rdata_fast}"

    assert rdata_slow == rdata_fast, "Standard and fast read results should match"
    tb.log.info("Standard vs fast read verified")


@cocotb.test()
async def test_clock_divider_sweep(dut):
    """Test reads at multiple clock divider values."""
    tb = TB(dut)
    await init_qpi(dut, tb)

    # Program test data
    addr = 0x6000
    data = [0x12345678, 0x9ABCDEF0, 0xFEDCBA98, 0x76543210]
    await SPI_WRITE_ENABLE(dut, tb)
    await QPI_PAGE_PROGRAM(dut, tb, addr=addr, words=data, n_words=4)
    await SPI_WRITE_DISABLE(dut, tb)

    # Test at various divider values
    dividers = [0x00, 0x01, 0x02, 0x04, 0x08, 0x10, 0x1F]

    for div in dividers:
        await tb.config_ahb_master.write(0x34, div)
        rdata = await QPI_READ_WORDS(dut, tb, addr=addr, n_words=4)
        tb.log.info("CLK_DIV=0x%02x: read %s", div, [hex(x) for x in rdata])
        assert rdata == data, f"Data mismatch at CLK_DIV=0x{div:02x}: got {rdata}"

    # Restore default divider
    await tb.config_ahb_master.write(0x34, 0x01)
    tb.log.info("Clock divider sweep passed for all %d values", len(dividers))


@cocotb.test()
async def test_vary_n_rw_bytes(dut):
    """Test reads with all 16 QSPI_N_RW_BYTES values (1-16 bytes).

    Value-checks the QSPI_RDATA read-mux byte ordering for every one of
    the 16 reachable N_RW_BYTES selector values (qspi_controller.sv
    case 5'h00..5'h0F). Previously the byte-read loop only asserted the
    returned *length*, so a mis-ordering in any partial-width mux arm —
    or a regression of the silent-zero `default` — would not have been
    caught. The expected byte sequence is the little-endian expansion of
    the programmed word list; its 4/8/12/16-byte points are independently
    anchored by the word-read loop's `rdata == data[:n_words]` check.
    """
    tb = TB(dut)
    await init_qpi(dut, tb)

    # Program 16 bytes of known data
    addr = 0x7000
    data = [0xAABBCCDD, 0x11223344, 0x55667788, 0x99AABBCC]
    await SPI_WRITE_ENABLE(dut, tb)
    await QPI_PAGE_PROGRAM(dut, tb, addr=addr, words=data, n_words=4)
    await SPI_WRITE_DISABLE(dut, tb)

    # Reference: RDATA register block is little-endian within each word,
    # words in order (matches QPI_READ_WORDS asserting rdata == data).
    expected_bytes = []
    for w in data:
        expected_bytes += [(w >> (8 * b)) & 0xFF for b in range(4)]

    # QPI_READ_BYTES returns the raw 32-bit RDATA bus word for each
    # 1-byte access; the addressed byte lives on its native lane
    # ((0x10+i) % 4). Extract it so we value-check the actual data.
    def lane_bytes(rdata):
        return [(rdata[i] >> (8 * ((0x10 + i) % 4))) & 0xFF
                for i in range(len(rdata))]

    # Word-aligned byte reads (4/8/12/16) — these select case arms
    # 5'h03/5'h07/5'h0B/5'h0F, whose mapping is anchored by the
    # QPI_READ_WORDS contract below. Value-check, not just length.
    for n_bytes in (4, 8, 12, 16):
        rdata = await QPI_READ_BYTES(dut, tb, addr=addr, n_bytes=n_bytes)
        assert len(rdata) == n_bytes, f"Expected {n_bytes} bytes, got {len(rdata)}"
        got = lane_bytes(rdata)
        assert got == expected_bytes[:n_bytes], (
            f"word-aligned {n_bytes}-byte read mismatch\n"
            f"  got      {[hex(x) for x in got]}\n"
            f"  expected {[hex(x) for x in expected_bytes[:n_bytes]]}"
        )
        # Guards the silent-zero hazard removed from the case `default`:
        # a read must never come back all-zero for a non-zero payload.
        assert any(got), f"{n_bytes}-byte read returned all-zero (silent-zero regression)"
        tb.log.info("N_RW_BYTES=%d: %d bytes value-verified", n_bytes - 1, n_bytes)

    # Test word-level reads from 1 to 4 words
    for n_words in range(1, 5):
        rdata = await QPI_READ_WORDS(dut, tb, addr=addr, n_words=n_words)
        tb.log.info("N_WORDS=%d: read %s", n_words, [hex(x) for x in rdata])
        assert rdata == data[:n_words], f"Word read mismatch for n_words={n_words}"

    tb.log.info("Word-aligned N_RW_BYTES read-mux arms value-verified")


@cocotb.test(expect_fail=True)
async def test_qspi_partial_byte_read_ordering(dut):
    """KNOWN BUG (xfail): non-word-aligned QSPI byte reads return
    scrambled data.

    Surfaced 2026-05-18 while value-checking the QSPI_RDATA read-mux
    (the byte-read path was never value-checked — both call sites
    discarded the result). For N_RW_BYTES not of the form 4k-1, the
    case arms in qspi_controller.sv (5'h04..5'h0E) permute data_in_reg
    slices such that the RDATA register no longer matches the
    little-endian word layout that word reads return: e.g. a 5-byte
    read gives RDATA0=0xdd44aabb where the 4-byte read of the same
    address correctly gives 0xaabbccdd.

    This is the functional half of qspi_controller_optimisation_plan.md
    Task 3 ("non-shareable permutation"). Marked expect_fail so the bug
    is tracked in regression and this flips to a hard PASS once the
    read-mux is reworked (align byte order while sampling into
    data_in_reg, per Task 3 option 1). Must be fixed before tape-out.
    """
    tb = TB(dut)
    await init_qpi(dut, tb)

    addr = 0x7100
    data = [0xAABBCCDD, 0x11223344, 0x55667788, 0x99AABBCC]
    await SPI_WRITE_ENABLE(dut, tb)
    await QPI_PAGE_PROGRAM(dut, tb, addr=addr, words=data, n_words=4)
    await SPI_WRITE_DISABLE(dut, tb)

    expected_bytes = []
    for w in data:
        expected_bytes += [(w >> (8 * b)) & 0xFF for b in range(4)]

    for n_bytes in (1, 2, 3, 5, 6, 7, 9, 10, 11, 13, 14, 15):
        rdata = await QPI_READ_BYTES(dut, tb, addr=addr, n_bytes=n_bytes)
        got = [(rdata[i] >> (8 * ((0x10 + i) % 4))) & 0xFF
               for i in range(len(rdata))]
        assert got == expected_bytes[:n_bytes], (
            f"N_RW_BYTES={n_bytes-1}: partial-read byte order wrong\n"
            f"  got      {[hex(x) for x in got]}\n"
            f"  expected {[hex(x) for x in expected_bytes[:n_bytes]]}"
        )


@cocotb.test()
async def test_op_only_command(dut):
    """Test command-only transactions (no addr/dummy/data) - WREN, WRDI."""
    tb = TB(dut)
    await tb.cycle_reset()
    await SPI_RESET(dut, tb)

    # WREN (0x06) - command only, no addr, no data
    tb.log.info("Send WREN (command-only)")
    await SPI_WRITE_ENABLE(dut, tb)

    # Verify controller returns to idle
    status = await tb.config_ahb_master.read(0x04, 4)
    busy = int(status[0]['data'], 16) & 1
    assert busy == 0, "QSPI should be idle after command-only transaction"

    # WRDI (0x04) - another command-only
    tb.log.info("Send WRDI (command-only)")
    await SPI_WRITE_DISABLE(dut, tb)

    status = await tb.config_ahb_master.read(0x04, 4)
    busy = int(status[0]['data'], 16) & 1
    assert busy == 0, "QSPI should be idle after WRDI"

    tb.log.info("Command-only (OP->IDLE) transitions verified")


@cocotb.test()
async def test_reset_during_idle(dut):
    """Test that reset cleanly restores the controller from idle state."""
    tb = TB(dut)
    await init_qpi(dut, tb)

    # Program some data
    await SPI_WRITE_ENABLE(dut, tb)
    await QPI_PAGE_PROGRAM(dut, tb, addr=0x8000, words=[0xDEADCAFE], n_words=1)
    await SPI_WRITE_DISABLE(dut, tb)

    # Leave QPI mode cleanly before reset so the flash model stays in SPI mode
    await LEAVE_QPI_MODE(dut, tb)
    await tb.config_ahb_master.write(0x00, 0x0)

    # Now reset
    await tb.cycle_reset()

    # Verify controller is clean after reset
    status = await tb.config_ahb_master.read(0x04, 4)
    busy = int(status[0]['data'], 16) & 1
    assert busy == 0, "QSPI should not be busy after reset"

    # Verify registers are at default
    reg0 = await tb.config_ahb_master.read(0x00, 4)
    assert int(reg0[0]['data'], 16) == 0, "REG0 should be 0 after reset"

    reg13 = await tb.config_ahb_master.read(0x34, 4)
    assert int(reg13[0]['data'], 16) == 1, "REG13 should be 1 after reset"

    # Verify we can still operate after reset
    await SPI_RESET(dut, tb)
    rID = await SPI_READ_JEDIC(dut, tb)
    assert rID == ID, f"JEDEC ID mismatch after reset: 0x{rID:08x}"

    tb.log.info("Reset recovery verified")


@cocotb.test()
async def test_ahb_xip_read(dut):
    """Test AHB XIP read path end-to-end with cache."""
    tb = TB(dut)
    await init_qpi(dut, tb)

    # Program known data
    addr = 0x9000
    data = [0x11111111, 0x22222222, 0x33333333, 0x44444444]
    await SPI_WRITE_ENABLE(dut, tb)
    await QPI_PAGE_PROGRAM(dut, tb, addr=addr, words=data, n_words=4)
    await SPI_WRITE_DISABLE(dut, tb)

    # Switch to fast clock for XIP/cache operation (HCLK/2 = 50MHz, safe for flash)
    await tb.config_ahb_master.write(0x34, 0x01)

    # Do a dummy APB read to exercise the QSPI controller first
    await QPI_READ_WORDS(dut, tb, addr=addr, n_words=4, cont_read=True)

    # Enable continuous read + NO_CMD for XIP (matches QSPI_READ_TESTS sequence)
    QSPI_CTRL_REG = await tb.config_ahb_master.read(0x00, 4)
    QSPI_CTRL_REG = int(QSPI_CTRL_REG[0]['data'], 16)
    QSPI_CTRL_REG |= (1 << 25)  # NO_CMD
    QSPI_CTRL_REG |= (1 << 8)   # XIP_ACTIVE
    await tb.config_ahb_master.write(0x00, QSPI_CTRL_REG)

    # Configure AHB command register (fast read 0x0B, 4 dummy cycles for QPI)
    QSPI_AHB_CMD_REG = (4 << 12) + 0x0B
    await tb.config_ahb_master.write(0x30, QSPI_AHB_CMD_REG)

    # Enable cache and wait for ready
    await tb.config_ahb_master.read(CACHE_CONFIG_ADDR + 0x04, 4)
    await tb.config_ahb_master.write(CACHE_CONFIG_ADDR, 0x1)
    await tb.config_ahb_master.read(CACHE_CONFIG_ADDR, 4)

    for _ in range(1000):
        await tb.config_ahb_master.read(CACHE_CONFIG_ADDR, 4)
        status_tmp = await tb.config_ahb_master.read(CACHE_CONFIG_ADDR + 0x04, 4)
        cache_status = int(status_tmp[0]['data'], 16)
        if (cache_status & 0x3) == 2:
            break
        await Timer(time=10, units='us')
    else:
        raise AssertionError("Cache did not become ready")

    # Read via AHB data bus
    for i in range(4):
        rdata = await tb.data_ahb_master.read(addr + i*4, 4)
        val = int(rdata[0]['data'], 16)
        tb.log.info("AHB XIP read [%d]: 0x%08x (expected 0x%08x)", i, val, data[i])
        assert val == data[i], f"AHB XIP word {i} mismatch"

    # Read again (should be cached)
    for i in range(4):
        rdata = await tb.data_ahb_master.read(addr + i*4, 4)
        val = int(rdata[0]['data'], 16)
        assert val == data[i], f"Cached AHB XIP word {i} mismatch"

    # Disable XIP and cache
    await tb.config_ahb_master.write(0x00, 0x01)  # QIO only, clears XIP/CONT/NO_CMD
    await tb.config_ahb_master.write(CACHE_CONFIG_ADDR, 0x0)
    for _ in range(100):
        status_tmp = await tb.config_ahb_master.read(CACHE_CONFIG_ADDR + 0x04, 4)
        cache_status = int(status_tmp[0]['data'], 16)
        if (cache_status & 0x3) == 0:
            break
        await Timer(time=10, units='us')

    # Restore safe clock divider
    await tb.config_ahb_master.write(0x34, 0x05)

    # Note: flash may still be in QPI/continuous-read mode after XIP.
    # The next test's SPI_RESET handles this by sending RSTQIO first.

    tb.log.info("AHB XIP read path verified")


# ============================================================================
# XIP Line-Fill Regressions — minimum-delta variants of test_ahb_xip_read
# that isolate the QPI / NO_CMD / cont_read / plain-SPI axes.
# ============================================================================
#
# The known-passing baseline is `test_ahb_xip_read`, which runs in QPI mode
# with CTRL |= NO_CMD | CONT_READ and a prior APB "cont_read=True" warmup.
# Downstream consumers (nanosoc stage-0 etc.) want to know which of those
# knobs are load-bearing, and whether plain-SPI XIP works at all.
#
# Empirical summary at 2026-04-23:
#   ✓  Plain-SPI slow-read (0x03, 0 dummy), no NO_CMD, no warmup   — PASS
#   ✓  Plain-SPI fast-read (0x0B, 8 dummy), no NO_CMD, no warmup   — PASS
#   ✓  QPI + NO_CMD + cont_read warmup                             — PASS (baseline)
#   ✓  QPI + no NO_CMD + cont_read warmup                          — PASS
#   ✗  QPI + NO_CMD + NO warmup                                    — FAIL (flash isn't in CR)
#   ✗  QPI + no NO_CMD + NO warmup                                 — FAIL (QPI needs prior SPI→QPI handoff)
#
# Critical sequencing detail (learned the hard way): the CG092 cache reaches
# STATUS=READY only if the following APB sequence runs around the enable:
#   1. read  CACHE_CONFIG + 0x04  (STATUS) — pre-read
#   2. write CACHE_CONFIG = 1               — enable
#   3. read  CACHE_CONFIG                   — post-read CONFIG
#   4. poll: read CACHE_CONFIG, read CACHE_CONFIG + 0x04; break on STATUS & 3 == 2
# Omitting any of steps 1/3/4 leaves STATUS stuck at 0x1 (transitioning). We
# don't know why today — it feels like a read-side ACK handshake in the
# CG092 reg block. `_xip_baseline_minus()` encapsulates the working sequence.
# ============================================================================


async def _xip_baseline_minus(dut, tb, *, opcode, dummy_cycles, qio_mode,
                              no_cmd, cont_read_warmup, addr=0xA000,
                              clk_div=2):
    """Parameterised variant of test_ahb_xip_read. Reports which axes are
    enabled so failures are easy to triage. Programs 4 known words then
    reads them back through the AHB XIP path."""
    tb.log.info(
        "XIP variant: opcode=0x%02x dummy=%d qio=%d no_cmd=%d "
        "cont_read_warmup=%d clk_div=%d",
        opcode, dummy_cycles, qio_mode, no_cmd, cont_read_warmup, clk_div)

    await init_qpi(dut, tb)

    data = [0xDECAFE00, 0xDECAFE01, 0xDECAFE02, 0xDECAFE03]
    await SPI_WRITE_ENABLE(dut, tb)
    await QPI_PAGE_PROGRAM(dut, tb, addr=addr, words=data, n_words=4)
    await SPI_WRITE_DISABLE(dut, tb)

    if not qio_mode:
        await LEAVE_QPI_MODE(dut, tb)
        await tb.config_ahb_master.write(0x00, 0x0)  # clear QIO_MODE

    await tb.config_ahb_master.write(0x34, clk_div)

    if cont_read_warmup:
        # The baseline test's "dummy APB read to exercise the controller".
        # In QPI mode it also primes the flash into continuous-read mode
        # and leaves MODE_CODE=0xA0 + CONT_READ=1 in CTRL. Those bits are
        # LOAD-BEARING — without them, the next APB read to flash after
        # XIP enable sends the wrong continuation sequence and the cache
        # never reaches READY. PRESERVE them via read-modify-write below.
        if qio_mode and not no_cmd:
            # NO_CMD=0: every line fill sends the opcode, so the flash must
            # not be left in continuous-read mode (mode byte Axh), or it
            # takes the next opcode as address bits. Use mode byte FFh:
            # CONT_READ stays set because the two mode cycles are part of
            # the 0Bh SQI read frame, but the flash never enters
            # continuous-read. (This only worked before because the
            # controller sent the previous command's mode code, 00h, on the
            # first read after MODE_CODE changed.)
            r = await tb.config_ahb_master.read(0x00, 4)
            ctrl = int(r[0]['data'], 16) | (0xFF << 16) | (1 << 24)
            await tb.config_ahb_master.write(0x00, ctrl)
        await QPI_READ_WORDS(dut, tb, addr=addr, n_words=4, cont_read=True)

    # Read-modify-write CTRL so the MODE_CODE and CONT_READ bits set by
    # the warmup survive. Without this the XIP path deadlocks even if
    # NO_CMD is asserted (see test_xip_baseline_sanity — same args, full
    # overwrite, fails; same args, RMW, passes).
    r = await tb.config_ahb_master.read(0x00, 4)
    ctrl = int(r[0]['data'], 16)
    if qio_mode:
        ctrl |= (1 << 0)
    else:
        ctrl &= ~(1 << 0)
    if no_cmd:
        ctrl |= (1 << 25)
    else:
        ctrl &= ~(1 << 25)
    ctrl |= (1 << 8)       # XIP_ACTIVE
    await tb.config_ahb_master.write(0x00, ctrl)

    await tb.config_ahb_master.write(0x30, (dummy_cycles << 12) | opcode)

    # Match the reference sequence exactly: pre-read STATUS, write
    # CACHE_CONFIG=1, post-read CONFIG, then poll STATUS AND CONFIG per
    # iteration. Empirically some of these reads are load-bearing; until
    # we know which, mirror the baseline verbatim.
    await tb.config_ahb_master.read(CACHE_CONFIG_ADDR + 0x04, 4)
    await tb.config_ahb_master.write(CACHE_CONFIG_ADDR, 0x1)
    await tb.config_ahb_master.read(CACHE_CONFIG_ADDR, 4)
    for _ in range(500):
        await tb.config_ahb_master.read(CACHE_CONFIG_ADDR, 4)
        status_tmp = await tb.config_ahb_master.read(
            CACHE_CONFIG_ADDR + 0x04, 4)
        if (int(status_tmp[0]['data'], 16) & 0x3) == 2:
            break
        await Timer(time=10, units='us')
    else:
        # Dump STATUS for diagnosis and tear down cleanly before raising.
        status_tmp = await tb.config_ahb_master.read(
            CACHE_CONFIG_ADDR + 0x04, 4)
        cs = int(status_tmp[0]['data'], 16)
        await tb.config_ahb_master.write(0x00, 0x0)
        await tb.config_ahb_master.write(CACHE_CONFIG_ADDR, 0x0)
        raise AssertionError(
            f"Cache did not reach READY (STATUS & 0x3 stuck at "
            f"0x{cs & 3:x})")

    got = []
    for i in range(4):
        r = await tb.data_ahb_master.read(addr + i * 4, 4)
        got.append(int(r[0]['data'], 16))
        tb.log.info("  AHB XIP [%d] @ 0x%08x = 0x%08x (expect 0x%08x)",
                    i, addr + i * 4, got[-1], data[i])

    await tb.config_ahb_master.write(0x00, 0x0)
    await tb.config_ahb_master.write(CACHE_CONFIG_ADDR, 0x0)
    await tb.config_ahb_master.write(0x34, 0x05)

    mismatches = [(i, g, e) for i, (g, e) in enumerate(zip(got, data))
                  if g != e]
    assert not mismatches, (
        f"Line-fill mismatch ({len(mismatches)} word(s)): "
        + ", ".join(f"[{i}] got=0x{g:08x} exp=0x{e:08x}"
                    for i, g, e in mismatches))


@cocotb.test()
async def test_xip_baseline_sanity(dut):
    """Bit-for-bit clone of test_ahb_xip_read but using _xip_baseline_minus
    with the same arg values. If this passes but the variants above fail,
    the failure is in the arg combination, not in our helper. If this
    FAILS but test_ahb_xip_read passes, there is a small sequencing
    detail in the helper that matters and needs to be traced down."""
    tb = TB(dut)
    await _xip_baseline_minus(dut, tb, opcode=0x0B, dummy_cycles=4,
                              qio_mode=True, no_cmd=True,
                              cont_read_warmup=True, clk_div=1)


@cocotb.test(expect_error=Exception)
async def test_xip_qpi_no_cont_read_no_nocmd(dut):
    """PROBE (xfail): QPI line-fill with NO cont_read warmup.

    expect_error=Exception (not expect_fail): the desync makes the flash
    never drive its IO bus, so the cocotbext-ahb master raises a plain
    Exception ("AHB.SLAVE signals are not resolvable") — an *error*, not
    an assertion failure, so expect_fail would not match it.

    Baseline minus BOTH cont_read warmup AND NO_CMD — cache issues a
    full opcode+addr+data on every line fill, flash in QPI but not
    continuous-read mode.

    CONCLUSION (VCD root-cause 2026-05-18, docs/xip_cocotb_failures_
    findings.md mode 1): the cont_read warmup is **load-bearing**, by
    confirmed protocol constraint — qspi_controller only enters the
    MODE state (emits the QPI mode byte) when cont_read_latched==1, but
    the SST26VF064B SQI_HS_READ (0x0B) *unconditionally* consumes a
    2-nibble Mode byte + 4 dummy nibbles. Skipping the warmup desyncs
    framing; the flash never drives its IO bus (Z → AHB). This is the
    documented constraint, not an RTL defect for the intended XiP
    use-case (which always warms up). Kept as expect_fail so the
    constraint is regression-tracked; flips to PASS only if the
    controller is taught a warmup-free QPI framing (a scoped feature,
    AHB_SPI_SETUP register-map change — see findings doc).
    """
    tb = TB(dut)
    await _xip_baseline_minus(dut, tb, opcode=0x0B, dummy_cycles=4,
                              qio_mode=True, no_cmd=False,
                              cont_read_warmup=False)


@cocotb.test(expect_error=Exception)
async def test_xip_qpi_no_cont_read_warmup(dut):
    """PROBE (xfail): QPI + NO_CMD, but skip the cont_read APB warmup.

    Probe answered (see test_xip_qpi_no_cont_read_no_nocmd and
    docs/xip_cocotb_failures_findings.md mode 1): the warmup is
    load-bearing — stage-0 / any QPI XiP bring-up MUST perform the
    cont_read warmup (CONT_READ=1, MODE_CODE=0xA0). expect_fail tracks
    the confirmed constraint; flips to PASS only with a warmup-free QPI
    framing feature in the controller.
    """
    tb = TB(dut)
    await _xip_baseline_minus(dut, tb, opcode=0x0B, dummy_cycles=4,
                              qio_mode=True, no_cmd=True,
                              cont_read_warmup=False)


@cocotb.test()
async def test_xip_qpi_no_nocmd(dut):
    """Baseline minus NO_CMD.

    Still QPI, still does the cont_read warmup, but with NO_CMD=0 so the
    controller re-issues the opcode on every cache line fill. If this
    fails, the controller's repeated-command path is broken.
    """
    tb = TB(dut)
    await _xip_baseline_minus(dut, tb, opcode=0x0B, dummy_cycles=4,
                              qio_mode=True, no_cmd=False,
                              cont_read_warmup=True)


@cocotb.test()
async def test_xip_plain_spi_no_flash_write(dut):
    """Plain-SPI XIP on an erased (all-0xFF) flash region.

    Models how `nanosoc-ethernet-flash-system`'s `cocotb/soc_boot_flash`
    sees the part: a clean 0xFF region read over the plain-SPI XIP path
    with no programmed data. If this passes, the other plain-SPI tests
    are failing because SPI_WRITE_ENABLE / QPI_PAGE_PROGRAM left flash in
    a state the cache can't talk to.

    Test-isolation note (shared-sim): the suite runs every test in one
    simulation with no flash reset between tests. Two hazards:

      (a) Flash MODE desync. A predecessor (test_xip_qpi_no_nocmd) leaves
          the flash in QPI continuous-read; the hardened SPI_RESET
          (SST26VF064B.py) robustly recovers it — without that this
          read Z'd out (X/Z on the AHB data path).

      (b) Flash DATA collision. test_bug1_rdata_latch page-programs
          0xDEADBEEF at flash 0x1000 and never erases it; NOR program
          only clears bits, so this test (which expects fresh 0xFF at
          0x1000) read 0xDEADBEEF for word 0. Cured generally by an
          explicit SECTOR ERASE of the region below — true
          erase-before-use, order-independent, made affordable by the
          `defparam I0.Tse=1_000` in ahb_qspi_cocotb.v (~1 us vs 25 ms).
    """
    tb = TB(dut)
    await tb.cycle_reset()
    await SPI_RESET(dut, tb)

    # The 4 KiB sector at 0x1000 is shared with test_bug1_rdata_latch
    # (which programs 0xDEADBEEF there). Erase it so the region is
    # genuinely fresh 0xFF regardless of test order. Expected read value
    # is 0xFFFFFFFF for every word.
    addr = 0x1000
    expected = 0xFFFFFFFF
    await SPI_SECTOR_ERASE(dut, tb, addr=addr)

    # Plain-SPI XIP setup.
    await tb.config_ahb_master.write(0x34, 0x02)  # CLK_DIV=2
    await tb.config_ahb_master.write(0x30, (0 << 12) | 0x03)  # slow read
    await tb.config_ahb_master.write(0x00, (1 << 8))  # XIP only

    # Enable cache + wait for READY.
    #
    # Each SR read is immediately preceded by a throwaway CONFIG read
    # with NO Timer between the two: cmsdk_ahb_to_apb holds HREADYOUT=1
    # and registered HRDATA while idle, so an *isolated* cocotbext-ahb
    # single read tears its address phase down zero-width and returns
    # stale data forever — the cache genuinely reaches READY (see
    # docs/xip_cocotb_failures_findings.md, failure mode 2). A
    # back-to-back read pair lands the SR read while the bus is
    # non-idle => fresh data. Mirrors _xip_baseline_minus and how a
    # real CPU/DMA master issues the access.
    await tb.config_ahb_master.write(CACHE_CONFIG_ADDR, 0x1)
    for _ in range(500):
        await tb.config_ahb_master.read(CACHE_CONFIG_ADDR, 4)  # prime
        s = await tb.config_ahb_master.read(CACHE_CONFIG_ADDR + 0x04, 4)
        if (int(s[0]['data'], 16) & 0x3) == 2:
            break
        await Timer(time=10, units='us')
    else:
        await tb.config_ahb_master.read(CACHE_CONFIG_ADDR, 4)  # prime
        s = await tb.config_ahb_master.read(CACHE_CONFIG_ADDR + 0x04, 4)
        await tb.config_ahb_master.write(0x00, 0x0)
        await tb.config_ahb_master.write(CACHE_CONFIG_ADDR, 0x0)
        raise AssertionError(
            f"Cache did not reach READY (STATUS & 0x3 stuck at "
            f"0x{int(s[0]['data'], 16) & 3:x})")

    got = []
    for i in range(4):
        r = await tb.data_ahb_master.read(addr + i * 4, 4)
        got.append(int(r[0]['data'], 16))
        tb.log.info("  AHB XIP [%d] = 0x%08x (expect 0x%08x)",
                    i, got[-1], expected)

    await tb.config_ahb_master.write(0x00, 0x0)
    await tb.config_ahb_master.write(CACHE_CONFIG_ADDR, 0x0)

    mismatches = [(i, g) for i, g in enumerate(got) if g != expected]
    assert not mismatches, (
        "Read-0xFF line fill mismatch: "
        + ", ".join(f"[{i}] got=0x{g:08x}" for i, g in mismatches))


@cocotb.test()
async def test_xip_plain_spi_minimum(dut):
    """The minimum configuration stage-0 needs: plain SPI, no NO_CMD, no
    cont_read warmup, slow-read opcode. This is the exact pattern that
    returned magic + zeros in nanosoc-ethernet-flash-system.
    """
    tb = TB(dut)
    await _xip_baseline_minus(dut, tb, opcode=0x03, dummy_cycles=0,
                              qio_mode=False, no_cmd=False,
                              cont_read_warmup=False)


@cocotb.test()
async def test_xip_plain_spi_fast_read(dut):
    """Same as above but with fast-read (0x0B) + 8 dummy cycles — the
    standard SPI-mode read that most SPI flashes support."""
    tb = TB(dut)
    await _xip_baseline_minus(dut, tb, opcode=0x0B, dummy_cycles=8,
                              qio_mode=False, no_cmd=False,
                              cont_read_warmup=False)



#
# Downstream nanosoc-ethernet-flash-system's stage-0 bootrom originally used
# the AHB XIP + cache path with a plain SPI read opcode (0x03 or 0x0B) and
# WITHOUT NO_CMD / continuous-read. In that mode the first word of a cache
# line (16 B) returned the correct bytes but subsequent words read zero,
# forcing stage-0 to fall back to APB-driven single-word reads at a 30x
# perf cost. These regressions exercise exactly that mode so the fix
# (wherever it ends up — qspi_controller byte-counter / nCS gating, cache
# line fill sequencer, or ahb_qspi_interface handshake) has a permanent
# check against a repeat of that regression.
# ============================================================================


async def _xip_plain_spi_fill_body(dut, tb, *, opcode, dummy_cycles,
                                   addr=0x30000):
    """Shared body for the plain-SPI XIP regression: program 4 known words,
    leave the flash in SPI mode, configure AHB XIP with `opcode` + `dummy
    cycles`, enable cache, read the 4 words back via the AHB data master
    and assert they match.
    """
    await init_qpi(dut, tb)

    # ROOT CAUSE of the "0x84800000" corruption (bisected 2026-05-18,
    # docs/xip_cocotb_failures_findings.md): NOR flash page-program only
    # clears bits (1->0), never sets them. This helper previously
    # defaulted to addr=0xA000 — the SAME default _xip_baseline_minus
    # uses — and several QPI tests (test_xip_qpi_no_cont_read_no_nocmd
    # /_warmup, test_xip_baseline_sanity, ...) program 0xDECAFE0x there
    # first. Re-programming 0xA5A5000x WITHOUT an erase ANDs into the
    # stale bits: 0xDECAFE00 & 0xA5A50001 == 0x84800000 exactly
    # (verified by arithmetic + sim). A TEST-ISOLATION bug — NOT an
    # RTL/cache defect, NOT CDC, NOT the documented stage-0 bug (that
    # path preloads via $readmemh).
    #
    # Fix = a dedicated flash address no other test touches. The
    # textbook fix (erase-before-program) is impractical here: the
    # SST26 model's erase ops are 25-50 ms of *simulated* time
    # (Tse/Tbe/Tsce), ~700x this test's runtime — it would blow the
    # cocotb timeout. `addr` defaults to a private region and the two
    # callers pass distinct addresses so they cannot collide with each
    # other or any other test. (Suite-wide erase/address hygiene is a
    # tracked follow-up — see findings doc.)
    data = [0xA5A50001, 0xA5A50002, 0xA5A50003, 0xA5A50004]
    await SPI_WRITE_ENABLE(dut, tb)
    await QPI_PAGE_PROGRAM(dut, tb, addr=addr, words=data, n_words=4)
    await SPI_WRITE_DISABLE(dut, tb)

    # Leave QPI — the whole point is to read back over plain SPI.
    await LEAVE_QPI_MODE(dut, tb)
    await tb.config_ahb_master.write(0x00, 0x0)  # CTRL: QIO_MODE=0

    # CLK_DIV=2 (HCLK/4=25 MHz) — inside SST26 fast-read spec, ≥2 per
    # enforcement added in commit 62a0b94.
    await tb.config_ahb_master.write(0x34, 0x02)

    # Minimal plain-SPI XIP enable — the naive-bootrom path this
    # regression is meant to exercise. (An earlier "RMW-CTRL +
    # bracketed-read" rework here was chasing a red-herring root cause
    # — see findings doc — and is reverted; the real bug was the
    # missing erase above.)
    await tb.config_ahb_master.write(0x30, (dummy_cycles << 12) | opcode)
    await tb.config_ahb_master.write(0x00, (1 << 8))

    # Cache-ready poll. The throwaway CONFIG read before each SR read
    # (no Timer between) defeats the cmsdk_ahb_to_apb idle-HREADYOUT /
    # stale-registered-HRDATA artefact that makes an isolated
    # cocotbext-ahb single read return stale data
    # (docs/xip_cocotb_failures_findings.md, mode 2). This is a
    # genuine, separately-verified harness fix and is kept.
    await tb.config_ahb_master.write(CACHE_CONFIG_ADDR, 0x1)
    for _ in range(1000):
        await tb.config_ahb_master.read(CACHE_CONFIG_ADDR, 4)  # prime
        status_tmp = await tb.config_ahb_master.read(
            CACHE_CONFIG_ADDR + 0x04, 4)
        if (int(status_tmp[0]['data'], 16) & 0x3) == 2:
            break
        await Timer(time=10, units='us')
    else:
        raise AssertionError("Cache did not become ready")

    # Read 4 consecutive words — all four live in the same 16-B cache line.
    # This is the specific access pattern that triggered the downstream bug:
    # stage-0 did a `ldr r0, [hdr+0]; ldr r1, [hdr+4]` and got magic + 0.
    got = []
    for i in range(4):
        rdata = await tb.data_ahb_master.read(addr + i * 4, 4)
        val = int(rdata[0]['data'], 16)
        got.append(val)
        tb.log.info("XIP read [%d] @ 0x%08x = 0x%08x (expected 0x%08x)",
                    i, addr + i * 4, val, data[i])

    # Clean up — back to a neutral state for the next test.
    await tb.config_ahb_master.write(0x00, 0x00)  # XIP off, QIO off
    await tb.config_ahb_master.write(CACHE_CONFIG_ADDR, 0x0)
    await tb.config_ahb_master.write(0x34, 0x05)

    # Assert AFTER cleanup so a failure doesn't leave the controller in
    # XIP mode and tripping up the next test via test-order coupling.
    mismatches = [i for i, (g, e) in enumerate(zip(got, data)) if g != e]
    assert not mismatches, (
        f"Plain-SPI XIP line fill returned wrong data: "
        f"word(s) {mismatches} mismatched. got={[hex(g) for g in got]}, "
        f"expected={[hex(e) for e in data]}"
    )


@cocotb.test()
async def test_xip_plain_spi_fast_read_line_fill(dut):
    """XIP line fill via plain-SPI 0x0B fast-read (8 dummy cycles).

    Regression: without NO_CMD + continuous-read the cache fetched the
    first word correctly but returned 0 for words 1-3 of the 16-B line.
    """
    tb = TB(dut)
    await _xip_plain_spi_fill_body(dut, tb, opcode=0x0B, dummy_cycles=8,
                                   addr=0x30000)


@cocotb.test()
async def test_xip_plain_spi_slow_read_line_fill(dut):
    """XIP line fill via plain-SPI 0x03 slow-read (0 dummy cycles).

    Same regression on the simplest possible opcode — 0x03 requires no
    dummy cycles and is the lowest-common-denominator SPI read. If even
    this fails the issue isn't in the dummy-cycle path but in the cache
    line-fill sequencing proper.
    """
    tb = TB(dut)
    await _xip_plain_spi_fill_body(dut, tb, opcode=0x03, dummy_cycles=0,
                                   addr=0x34000)


@cocotb.test()
async def test_xip_plain_spi_line_fill_clkdiv_sweep(dut):
    """Run the plain-SPI XIP line-fill across CLK_DIV values to catch any
    CDC-race corner where the line-fill sequencer exits before all four
    words have been shifted in. CLK_DIV ≥ 2 is required by the controller
    post-62a0b94; stop at 8 (see below).

    Uses `_xip_baseline_minus` so the cache-enable APB sequence matches
    the baseline. Prior versions of this test open-coded a shorter
    sequence and hit the cache-stuck-at-0x1 symptom described in
    `test_xip_baseline_sanity`.

    CLK_DIV 16 was dropped from the sweep (H-PIPE fix, Oct 2026): this bench
    builds the IP with WATCHDOG_WIDTH=12 (4095 HCLK), and a plain-SPI
    FAST_READ line fill at CLK_DIV=16 takes longer than that, so the
    watchdog answers it with ERROR. It used to "pass" only because HRDATA
    was not reset and still held the CLK_DIV=8 iteration's line (every
    iteration programs the same pattern), and the test does not check
    HRESP. CLK_DIV=8 is the largest divider that fits the 12-bit watchdog.
    """
    tb = TB(dut)
    for clk_div in (2, 4, 8):
        tb.log.info("--- CLK_DIV = %d ---", clk_div)
        await _xip_baseline_minus(
            dut, tb, opcode=0x0B, dummy_cycles=8,
            qio_mode=False, no_cmd=False, cont_read_warmup=False,
            addr=0xB000 + clk_div * 0x100, clk_div=clk_div)


# ============================================================================
# Additional Tests for Bug Hunting
# ============================================================================

@cocotb.test()
async def test_rdata_regs_readonly(dut):
    """Verify RDATA registers (REG4-7) are read-only and cannot be written."""
    tb = TB(dut)
    await tb.cycle_reset()

    rdata_addrs = [0x10, 0x14, 0x18, 0x1C]
    # Read initial values (should be 0 after reset)
    for addr in rdata_addrs:
        data = await tb.config_ahb_master.read(addr, 4)
        initial = int(data[0]['data'], 16)
        tb.log.info("RDATA @ 0x%02x initial = 0x%08x", addr, initial)

    # Attempt to write non-zero values
    for addr in rdata_addrs:
        await tb.config_ahb_master.write(addr, 0xDEADBEEF)

    # Read back — should still be 0 (or unchanged)
    for addr in rdata_addrs:
        data = await tb.config_ahb_master.read(addr, 4)
        val = int(data[0]['data'], 16)
        tb.log.info("RDATA @ 0x%02x after write attempt = 0x%08x", addr, val)
        assert val == 0, f"RDATA @ 0x{addr:02x} should be read-only, got 0x{val:08x}"

    tb.log.info("RDATA read-only protection verified")


@cocotb.test()
async def test_data_pattern_integrity(dut):
    """Program and verify various data patterns to detect bit-stuck/swap bugs."""
    tb = TB(dut)
    await init_qpi(dut, tb)

    patterns = [
        ("all_zeros",     [0x00000000, 0x00000000, 0x00000000, 0x00000000]),
        ("all_ones",      [0xFFFFFFFF, 0xFFFFFFFF, 0xFFFFFFFF, 0xFFFFFFFF]),
        ("alternating_a", [0xAAAAAAAA, 0xAAAAAAAA, 0xAAAAAAAA, 0xAAAAAAAA]),
        ("alternating_5", [0x55555555, 0x55555555, 0x55555555, 0x55555555]),
        ("walking_1",     [0x00000001, 0x00000002, 0x00000004, 0x00000008]),
        ("walking_0",     [0xFFFFFFFE, 0xFFFFFFFD, 0xFFFFFFFB, 0xFFFFFFF7]),
        ("byte_ramp",     [0x00010203, 0x04050607, 0x08090A0B, 0x0C0D0E0F]),
        ("nibble_swap",   [0xF0F0F0F0, 0x0F0F0F0F, 0xF0F0F0F0, 0x0F0F0F0F]),
    ]

    for idx, (name, data) in enumerate(patterns):
        addr = 0xA000 + idx * 0x100

        await SPI_WRITE_ENABLE(dut, tb)
        await QPI_PAGE_PROGRAM(dut, tb, addr=addr, words=data, n_words=4)
        await SPI_WRITE_DISABLE(dut, tb)

        rdata = await QPI_READ_WORDS(dut, tb, addr=addr, n_words=4)
        tb.log.info("Pattern '%s' @ 0x%06x: wrote %s, read %s",
                    name, addr, [hex(x) for x in data], [hex(x) for x in rdata])
        assert rdata == data, f"Pattern '{name}' mismatch at 0x{addr:06x}: got {rdata}"

    tb.log.info("All data patterns verified")


@cocotb.test()
async def test_back_to_back_commands(dut):
    """Issue many commands back-to-back without extra delays to stress handshake."""
    tb = TB(dut)
    await init_qpi(dut, tb)

    # Program some data first
    data = [0xBEEFCAFE, 0x12345678, 0xDEADC0DE, 0xFACEFEED]
    await SPI_WRITE_ENABLE(dut, tb)
    await QPI_PAGE_PROGRAM(dut, tb, addr=0xB000, words=data, n_words=4)
    await SPI_WRITE_DISABLE(dut, tb)

    # Issue 50 back-to-back reads to the same address
    for i in range(50):
        rdata = await QPI_READ_WORDS(dut, tb, addr=0xB000, n_words=4)
        assert rdata == data, f"Back-to-back read {i} mismatch: got {rdata}"

    tb.log.info("50 back-to-back reads passed")


@cocotb.test()
async def test_enable_while_busy(dut):
    """Assert ENABLE while controller is busy — verify no corruption."""
    tb = TB(dut)
    await init_qpi(dut, tb)

    # Program data
    data = [0xAAAABBBB]
    await SPI_WRITE_ENABLE(dut, tb)
    await QPI_PAGE_PROGRAM(dut, tb, addr=0xC000, words=data, n_words=1)
    await SPI_WRITE_DISABLE(dut, tb)

    # Start a slow read (standard SPI read with 0 dummy, slower clock)
    await LEAVE_QPI_MODE(dut, tb)
    await tb.config_ahb_master.write(0x00, 0x0)
    await tb.config_ahb_master.write(0x34, 0x1F)  # Slowest clock

    # Start a read command
    await tb.config_ahb_master.write(0x0C, 0xC000)  # Address
    QSPI_INSTR = 0x0B  # Fast read
    QSPI_INSTR += (1 << 9)   # read=1
    QSPI_INSTR += (1 << 11)  # addr_en=1
    QSPI_INSTR += (8 << 12)  # dummy=8
    QSPI_INSTR += (3 << 16)  # n_rw_bytes=3 (4 bytes)
    await tb.config_ahb_master.write(0x08, QSPI_INSTR)
    await tb.config_ahb_master.write(0x08, QSPI_INSTR | (1 << 8))

    # While busy, try to issue another enable (should be ignored or queued)
    await ClockCycles(dut.HCLK, 5)
    status = await tb.config_ahb_master.read(0x04, 4)
    if int(status[0]['data'], 16) & 1:
        tb.log.info("Controller is busy, attempting second ENABLE")
        # Write another command with ENABLE — this should not corrupt the ongoing one
        await tb.config_ahb_master.write(0x08, 0x0000019F)  # JEDEC with enable

    # Wait for original to complete
    await poll_busy_clear(dut, tb)

    # Read back and verify data is still correct
    rdata = await SPI_READ_WORDS(dut, tb, addr=0xC000, n_words=1)
    tb.log.info("Data after double-enable: 0x%08x (expected 0x%08x)", rdata[0], data[0])

    # Restore clock
    await tb.config_ahb_master.write(0x34, 0x01)
    tb.log.info("Enable-while-busy test completed without hang")


@cocotb.test()
async def test_reset_during_transaction(dut):
    """Assert reset mid-transaction and verify clean recovery."""
    tb = TB(dut)
    await tb.cycle_reset()
    await SPI_RESET(dut, tb)
    # Stay in SPI mode so the flash model is in a known state after reset

    # Start a slow read with maximum clock divider
    await tb.config_ahb_master.write(0x34, 0x1F)

    # Issue a SPI read command
    await tb.config_ahb_master.write(0x0C, 0x0000)
    QSPI_INSTR = 0x0B  # Fast read
    QSPI_INSTR += (1 << 9)   # read=1
    QSPI_INSTR += (1 << 11)  # addr_en=1
    QSPI_INSTR += (8 << 12)  # dummy=8 (SPI fast read)
    QSPI_INSTR += (15 << 16) # n_rw_bytes=15 (16 bytes)
    await tb.config_ahb_master.write(0x08, QSPI_INSTR)
    await tb.config_ahb_master.write(0x08, QSPI_INSTR | (1 << 8))

    # Wait a few cycles then reset mid-transaction
    await ClockCycles(dut.HCLK, 20)

    # Assert reset
    await tb.cycle_reset()

    # Verify registers are at defaults
    status = await tb.config_ahb_master.read(0x04, 4)
    busy = int(status[0]['data'], 16) & 1
    tb.log.info("BUSY after mid-transaction reset: %d", busy)
    assert busy == 0, "Controller should not be busy after reset"

    reg0 = await tb.config_ahb_master.read(0x00, 4)
    assert int(reg0[0]['data'], 16) == 0, "REG0 should be 0 after reset"

    reg13 = await tb.config_ahb_master.read(0x34, 4)
    assert int(reg13[0]['data'], 16) == 1, "CLK_DIV should be 1 after reset"

    # Verify controller is functional post-reset
    await SPI_RESET(dut, tb)
    rID = await SPI_READ_JEDIC(dut, tb)
    assert rID == ID, f"JEDEC ID after mid-txn reset: 0x{rID:08x}"

    tb.log.info("Reset during transaction: clean recovery verified")


@cocotb.test()
async def test_simultaneous_rw_bits(dut):
    """Set both READ=1 and WRITE=1 simultaneously — verify no hang."""
    tb = TB(dut)
    await tb.cycle_reset()
    await SPI_RESET(dut, tb)

    # Issue command with both READ and WRITE enabled
    await tb.config_ahb_master.write(0x0C, 0x0000)  # Address
    QSPI_INSTR = 0x03  # Read opcode
    QSPI_INSTR += (1 << 9)   # read=1
    QSPI_INSTR += (1 << 10)  # write=1 (both set)
    QSPI_INSTR += (1 << 11)  # addr_en=1
    QSPI_INSTR += (0 << 12)  # dummy=0
    QSPI_INSTR += (3 << 16)  # n_rw_bytes=3

    await tb.config_ahb_master.write(0x08, QSPI_INSTR)
    await tb.config_ahb_master.write(0x08, QSPI_INSTR | (1 << 8))

    # Should not hang — wait with timeout
    await poll_busy_clear(dut, tb)

    tb.log.info("Simultaneous R+W bits: controller did not hang")


@cocotb.test()
async def test_address_boundary(dut):
    """Test reads at low and high flash addresses."""
    tb = TB(dut)
    await init_qpi(dut, tb)

    # Use addresses that other tests don't touch to avoid flash corruption cascade
    addr_low = 0x050000
    addr_high = 0x150000

    # Program at low address
    data_low = [0x11111111]
    await SPI_WRITE_ENABLE(dut, tb)
    await QPI_PAGE_PROGRAM(dut, tb, addr=addr_low, words=data_low, n_words=1)
    await SPI_WRITE_DISABLE(dut, tb)

    # Program at high address
    data_high = [0x22222222]
    await SPI_WRITE_ENABLE(dut, tb)
    await QPI_PAGE_PROGRAM(dut, tb, addr=addr_high, words=data_high, n_words=1)
    await SPI_WRITE_DISABLE(dut, tb)

    # Read from low address
    rdata = await QPI_READ_WORDS(dut, tb, addr=addr_low, n_words=1)
    tb.log.info("Address 0x%06x: 0x%08x", addr_low, rdata[0])
    assert rdata == data_low, "Low address mismatch"

    # Read from high address
    rdata = await QPI_READ_WORDS(dut, tb, addr=addr_high, n_words=1)
    tb.log.info("Address 0x%06x: 0x%08x", addr_high, rdata[0])
    assert rdata == data_high, "High address mismatch"

    tb.log.info("Address boundary test passed")


@cocotb.test()
async def test_xip_multiple_addresses(dut):
    """Test XIP reads across multiple non-contiguous addresses."""
    tb = TB(dut)
    await init_qpi(dut, tb)

    # Program data at several scattered addresses
    addrs = [0xD000, 0xD100, 0xD200, 0xD300]
    test_data = {}
    for i, addr in enumerate(addrs):
        data = [0x10000000 + i*0x1111 + j for j in range(4)]
        test_data[addr] = data
        await SPI_WRITE_ENABLE(dut, tb)
        await QPI_PAGE_PROGRAM(dut, tb, addr=addr, words=data, n_words=4)
        await SPI_WRITE_DISABLE(dut, tb)

    # Switch to fast clock for XIP/cache operation (HCLK/2, safe for flash)
    await tb.config_ahb_master.write(0x34, 0x01)

    # Do a dummy APB read to exercise the controller first
    await QPI_READ_WORDS(dut, tb, addr=addrs[0], n_words=4, cont_read=True)

    # Enable continuous read + NO_CMD + XIP (matches QSPI_READ_TESTS)
    QSPI_CTRL_REG = await tb.config_ahb_master.read(0x00, 4)
    QSPI_CTRL_REG = int(QSPI_CTRL_REG[0]['data'], 16)
    QSPI_CTRL_REG |= (1 << 25) | (1 << 8)  # NO_CMD + XIP_ACTIVE
    await tb.config_ahb_master.write(0x00, QSPI_CTRL_REG)

    await tb.config_ahb_master.write(0x30, (4 << 12) + 0x0B)

    # Enable cache and wait for ready
    await tb.config_ahb_master.write(CACHE_CONFIG_ADDR, 0x1)
    for _ in range(1000):
        await tb.config_ahb_master.read(CACHE_CONFIG_ADDR, 4)
        status_tmp = await tb.config_ahb_master.read(CACHE_CONFIG_ADDR + 0x04, 4)
        cache_status = int(status_tmp[0]['data'], 16)
        if (cache_status & 0x3) == 2:
            break
        await Timer(time=10, units='us')
    else:
        raise AssertionError("Cache did not become ready")

    # Read from each address via AHB
    for addr in addrs:
        for j in range(4):
            rdata = await tb.data_ahb_master.read(addr + j*4, 4)
            val = int(rdata[0]['data'], 16)
            expected = test_data[addr][j]
            assert val == expected, \
                f"XIP read 0x{addr+j*4:06x}: got 0x{val:08x}, expected 0x{expected:08x}"

    # Re-read in reverse order
    for addr in reversed(addrs):
        rdata = await tb.data_ahb_master.read(addr, 4)
        val = int(rdata[0]['data'], 16)
        assert val == test_data[addr][0], \
            f"XIP reverse read 0x{addr:06x} mismatch"

    # Disable XIP and cache
    await tb.config_ahb_master.write(0x00, 0x01)
    await tb.config_ahb_master.write(CACHE_CONFIG_ADDR, 0x0)
    for _ in range(100):
        status_tmp = await tb.config_ahb_master.read(CACHE_CONFIG_ADDR + 0x04, 4)
        cache_status = int(status_tmp[0]['data'], 16)
        if (cache_status & 0x3) == 0:
            break
        await Timer(time=10, units='us')

    # Restore safe clock divider
    await tb.config_ahb_master.write(0x34, 0x05)

    tb.log.info("XIP multi-address read test passed")


@cocotb.test()
async def test_spi_qpi_data_consistency(dut):
    """Program in QPI mode, read back in both QPI and SPI, compare."""
    tb = TB(dut)
    await init_qpi(dut, tb)

    # Program data in QPI mode
    addr = 0xE000
    data = [0xCAFEBABE, 0xDEADF00D, 0xBAADF00D, 0x0BADC0DE]
    await SPI_WRITE_ENABLE(dut, tb)
    await QPI_PAGE_PROGRAM(dut, tb, addr=addr, words=data, n_words=4)
    await SPI_WRITE_DISABLE(dut, tb)

    # Read in QPI mode
    rdata_qpi = await QPI_READ_WORDS(dut, tb, addr=addr, n_words=4)
    tb.log.info("QPI read: %s", [hex(x) for x in rdata_qpi])
    assert rdata_qpi == data, "QPI read mismatch"

    # Switch to SPI mode
    await LEAVE_QPI_MODE(dut, tb)
    await tb.config_ahb_master.write(0x00, 0x0)

    # Read in SPI mode
    rdata_spi = await SPI_READ_WORDS(dut, tb, addr=addr, n_words=4)
    tb.log.info("SPI read: %s", [hex(x) for x in rdata_spi])
    assert rdata_spi == data, "SPI read mismatch"

    # Cross-check
    assert rdata_qpi == rdata_spi, "QPI and SPI reads should return identical data"

    tb.log.info("SPI/QPI data consistency verified")


@cocotb.test()
async def test_irq_multiple_commands(dut):
    """Verify IRQ fires correctly across multiple sequential commands."""
    tb = TB(dut)
    await tb.cycle_reset()
    await SPI_RESET(dut, tb)

    # Issue 10 JEDEC ID reads, checking IRQ after each
    for i in range(10):
        assert dut.IRQ_QSPI_FINISHED.value == 0, f"IRQ should be 0 before command {i}"

        # JEDEC ID read
        await tb.config_ahb_master.write(0x08, 0x0002009F)
        await tb.config_ahb_master.write(0x08, 0x0002039F)

        # Wait for IRQ
        for _ in range(POLL_TIMEOUT_CYCLES):
            if dut.IRQ_QSPI_FINISHED.value == 1:
                break
            await ClockCycles(dut.HCLK, 1)
        else:
            raise AssertionError(f"IRQ did not assert after command {i}")

        # Clear IRQ
        await tb.config_ahb_master.write(0x04, 0x00000100)
        await ClockCycles(dut.HCLK, 5)
        assert dut.IRQ_QSPI_FINISHED.value == 0, f"IRQ should clear after cmd {i}"

    tb.log.info("IRQ verified across 10 sequential commands")


@cocotb.test()
async def test_multiword_program_sizes(dut):
    """Test page program with 1, 2, 3, 4 words and verify each independently."""
    tb = TB(dut)
    await init_qpi(dut, tb)

    for n_words in range(1, 5):
        addr = 0xF000 + (n_words - 1) * 0x100
        data = [0x10000000 * n_words + i for i in range(n_words)]
        # Pad to 4 words for the helper (it only writes n_words)
        data_padded = data + [0] * (4 - n_words)

        await SPI_WRITE_ENABLE(dut, tb)
        await QPI_PAGE_PROGRAM(dut, tb, addr=addr, words=data_padded[:n_words], n_words=n_words)
        await SPI_WRITE_DISABLE(dut, tb)

        rdata = await QPI_READ_WORDS(dut, tb, addr=addr, n_words=n_words)
        tb.log.info("Program %d words @ 0x%06x: %s", n_words, addr, [hex(x) for x in rdata])
        assert rdata == data, f"Mismatch for {n_words}-word program at 0x{addr:06x}"

    tb.log.info("Multiword program sizes (1-4) verified")


@cocotb.test()
async def test_clock_div_zero_bypass(dut):
    """Test CLK_DIV=0 (bypass mode, QSPI_SCLK=HCLK) — verify controller doesn't hang.

    Note: CLK_DIV=0 passes HCLK (100MHz) directly as QSPI_SCLK, which violates
    the SST26VF064B flash model's timing constraints. The flash model will corrupt
    its memory. This test only verifies the controller FSM completes without hanging.
    """
    tb = TB(dut)
    await tb.cycle_reset()
    await SPI_RESET(dut, tb)

    # Set CLK_DIV=0 (bypass) — will violate flash timing
    await tb.config_ahb_master.write(0x34, 0x00)

    # Issue a command-only transaction (WREN) — no data read needed
    await tb.config_ahb_master.write(0x08, 0x00000006)
    await tb.config_ahb_master.write(0x08, 0x00000106)

    # At CLK_DIV=0 the QSPI_SCLK equals HCLK, so the 2-FF CDC synchronizer
    # for BUSY cannot reliably capture the transition.  Just wait long enough
    # for the command to complete (8 SCLK cycles = 8 HCLK cycles at div=0).
    await ClockCycles(dut.HCLK, 50)

    # Restore safe divider before any further polling
    await tb.config_ahb_master.write(0x34, 0x05)

    # Now poll with the safe divider active
    await poll_busy_clear(dut, tb)

    tb.log.info("CLK_DIV=0 bypass mode test completed (controller did not hang)")


@cocotb.test()
async def test_continuous_read_to_normal(dut):
    """Switch between continuous read mode and normal mode, verify data."""
    tb = TB(dut)
    await init_qpi(dut, tb)

    addr = 0xF400
    data = [0xAAAA1111, 0xBBBB2222, 0xCCCC3333, 0xDDDD4444]
    await SPI_WRITE_ENABLE(dut, tb)
    await QPI_PAGE_PROGRAM(dut, tb, addr=addr, words=data, n_words=4)
    await SPI_WRITE_DISABLE(dut, tb)

    # Normal read
    rdata1 = await QPI_READ_WORDS(dut, tb, addr=addr, n_words=4, cont_read=False)
    assert rdata1 == data, "Normal read mismatch before continuous mode"

    # Enable continuous read mode
    rdata2 = await QPI_READ_WORDS(dut, tb, addr=addr, n_words=4, cont_read=True)
    assert rdata2 == data, "Continuous read mismatch"

    # Enable NO_CMD mode for subsequent reads
    QSPI_CTRL_REG = await tb.config_ahb_master.read(0x00, 4)
    QSPI_CTRL_REG = int(QSPI_CTRL_REG[0]['data'], 16)
    QSPI_CTRL_REG |= (1 << 25)
    await tb.config_ahb_master.write(0x00, QSPI_CTRL_REG)

    # Read same address with NO_CMD (should hit NO_FETCH path)
    rdata3 = await QPI_READ_WORDS(dut, tb, addr=addr, n_words=4, cont_read=True)
    assert rdata3 == data, "NO_CMD read mismatch"

    # Disable NO_CMD and continuous read, clear MODE_CODE
    # Keep only QIO_MODE bit, clear everything else
    await tb.config_ahb_master.write(0x00, 0x01)

    # The flash is still in continuous read mode — send a read with mode code 0xFF
    # to exit continuous read mode per SST26VF064B datasheet
    QSPI_CTRL_REG = 0x01 | (0xFF << 16) | (1 << 24)  # QIO + MODE_CODE=0xFF + CONT_READ
    await tb.config_ahb_master.write(0x00, QSPI_CTRL_REG)
    await QPI_READ_WORDS(dut, tb, addr=addr, n_words=4, cont_read=True)

    # Now clear continuous read mode fully
    await tb.config_ahb_master.write(0x00, 0x01)  # QIO_MODE only

    # Normal read again — should still work
    rdata4 = await QPI_READ_WORDS(dut, tb, addr=addr, n_words=4, cont_read=False)
    assert rdata4 == data, "Normal read mismatch after leaving continuous mode"

    tb.log.info("Continuous/normal mode transitions verified")


# ---------------------------------------------------------------------------
# Regression tests for the DATA_O "extra clock" hardware bug
#
# Background: During the data-output phase of a Page Program (or any SPI
# write), the controller's FSM has a counter-initialization guard cycle
# where byte_counter=0x1F. In the original RTL, the negedge shift-register
# logic ran unconditionally during this guard cycle, producing one extra
# SPI clock with one extra bit/nibble of data shifted onto MOSI before the
# real data payload.
#
# The simulation flash model (SST26VF064B) was tolerant of this timing
# quirk, so write-then-read round-trips cancelled out and existing tests
# passed. A real Micron N25Q256A (PmodSF3) on the PYNQ-Z2 board rejected
# every Page Program: WEL stayed set, WIP never asserted.
#
# The tests below verify SPI bus behaviour directly by counting QSPI_SCLK
# cycles and edges during each FSM phase — independent of any flash model
# response. They would have caught the bug on the original RTL.
# ---------------------------------------------------------------------------


async def _count_spi_clocks_in_cs_window(dut, timeout_ns=500_000):
    """Wait for CS low, count QSPI_SCLK rising edges until CS goes high.

    Returns the total number of rising edges observed while CS was
    asserted. Times out if CS stays high for the whole window.
    """
    from cocotb.triggers import Edge, First, Timer
    # Wait for CS to go low (start of SPI frame)
    t_start = Timer(time=timeout_ns, units='ns')
    while dut.QSPI_nCS.value == 1:
        trig = await First(Edge(dut.QSPI_nCS), t_start)
        if trig is t_start:
            raise AssertionError("Timed out waiting for QSPI_nCS to assert")
    # Count rising SCLK edges until CS rises
    n_edges = 0
    last_sclk = int(dut.QSPI_SCLK.value)
    t_frame = Timer(time=timeout_ns, units='ns')
    while True:
        trig = await First(
            Edge(dut.QSPI_SCLK),
            Edge(dut.QSPI_nCS),
            t_frame,
        )
        if trig is t_frame:
            raise AssertionError("SPI frame did not end within timeout")
        if dut.QSPI_nCS.value == 1:
            return n_edges
        new_sclk = int(dut.QSPI_SCLK.value)
        if last_sclk == 0 and new_sclk == 1:
            n_edges += 1
        last_sclk = new_sclk


@cocotb.test()
async def test_spi_write_clock_count(dut):
    """Verify exactly 8 + 24 + 8*N_bytes SPI clocks for a SPI PP.

    This is the regression test that would have caught the DATA_O
    extra-clock bug. Any count higher than expected indicates the bug
    has regressed.

    For PAGE_PROGRAM (0x02) in SPI mode with addr_en and N bytes of data:
      opcode  = 8 clocks
      address = 24 clocks (3 bytes)
      data    = 8 * N clocks
      total   = 32 + 8*N clocks
    """
    tb = TB(dut)
    await tb.cycle_reset()
    await SPI_RESET(dut, tb)
    await SPI_WRITE_ENABLE(dut, tb)
    await SPI_CLR_PROTECTION(dut, tb)

    # Set up a PP of 4 bytes in SPI mode (QIO_MODE=0)
    await tb.config_ahb_master.write(0x00, 0x00000000)  # CTRL = SPI mode
    await SPI_WRITE_ENABLE(dut, tb)
    addr = 0x1234
    n_bytes = 4
    await tb.config_ahb_master.write(0x0C, addr)
    await tb.config_ahb_master.write(0x20, 0xDEADBEEF)  # WDATA0

    QSPI_INSTR = 0x02            # CMD
    QSPI_INSTR |= (1 << 10)      # WRITE
    QSPI_INSTR |= (1 << 11)      # ADDR_EN
    QSPI_INSTR |= ((n_bytes - 1) << 16)  # N_RW_BYTES

    # Kick off the clock counter concurrently, then trigger the command
    expected = 8 + 24 + 8 * n_bytes
    counter = cocotb.start_soon(_count_spi_clocks_in_cs_window(dut))
    await tb.config_ahb_master.write(0x08, QSPI_INSTR)
    await tb.config_ahb_master.write(0x08, QSPI_INSTR | (1 << 8))
    await wait_for_irq(dut, tb)
    await poll_busy_clear(dut, tb)

    n_clocks = await counter
    tb.log.info("SPI PP clock count: observed=%d expected=%d", n_clocks, expected)
    assert n_clocks == expected, (
        f"SPI PP generated {n_clocks} SCLK edges, expected {expected}. "
        f"Excess clocks indicate the DATA_O extra-bit bug has regressed."
    )


@cocotb.test()
async def test_qpi_write_clock_count(dut):
    """Verify exactly 2 + 6 + 2*N_bytes SPI clocks for a QPI PP.

    In QPI mode 4 bits go over the bus per clock:
      opcode  = 2 clocks  (8 bits / 4 bits-per-clock)
      address = 6 clocks  (3 bytes * 2 clocks-per-byte)
      data    = 2 * N clocks
      total   = 8 + 2*N clocks
    """
    tb = TB(dut)
    await tb.cycle_reset()
    await SPI_RESET(dut, tb)
    await SET_QPI_MODE(dut, tb)
    await tb.config_ahb_master.write(0x00, 0x01)  # QIO_MODE=1
    await SPI_WRITE_ENABLE(dut, tb)
    await SPI_CLR_PROTECTION(dut, tb)

    addr = 0x2000
    n_bytes = 4
    await SPI_WRITE_ENABLE(dut, tb)
    await tb.config_ahb_master.write(0x0C, addr)
    await tb.config_ahb_master.write(0x20, 0xCAFEBABE)

    QSPI_INSTR = 0x02
    QSPI_INSTR |= (1 << 10)
    QSPI_INSTR |= (1 << 11)
    QSPI_INSTR |= ((n_bytes - 1) << 16)

    expected = 2 + 6 + 2 * n_bytes
    counter = cocotb.start_soon(_count_spi_clocks_in_cs_window(dut))
    await tb.config_ahb_master.write(0x08, QSPI_INSTR)
    await tb.config_ahb_master.write(0x08, QSPI_INSTR | (1 << 8))
    await wait_for_irq(dut, tb)
    await poll_busy_clear(dut, tb)

    n_clocks = await counter
    tb.log.info("QPI PP clock count: observed=%d expected=%d", n_clocks, expected)
    assert n_clocks == expected, (
        f"QPI PP generated {n_clocks} SCLK edges, expected {expected}. "
        f"Excess clocks indicate the DATA_O extra-bit bug has regressed."
    )


@cocotb.test()
async def test_spi_write_single_byte_clock_count(dut):
    """Verify a 1-byte SPI PP generates exactly 40 clocks (8 op + 24 addr + 8 data).

    The 1-byte case is the tightest stress on the DATA_O exit condition —
    if there's any off-by-one in the counter handling, it shows here.
    """
    tb = TB(dut)
    await tb.cycle_reset()
    await SPI_RESET(dut, tb)
    await SPI_WRITE_ENABLE(dut, tb)
    await SPI_CLR_PROTECTION(dut, tb)

    await tb.config_ahb_master.write(0x00, 0x00000000)
    await SPI_WRITE_ENABLE(dut, tb)

    await tb.config_ahb_master.write(0x0C, 0x3000)
    await tb.config_ahb_master.write(0x20, 0x000000A5)  # 1 data byte = 0xA5

    # PP, WRITE=1, ADDR_EN=1, N_RW_BYTES=0 (1 byte)
    QSPI_INSTR = 0x02 | (1 << 10) | (1 << 11) | (0 << 16)

    expected = 8 + 24 + 8   # = 40
    counter = cocotb.start_soon(_count_spi_clocks_in_cs_window(dut))
    await tb.config_ahb_master.write(0x08, QSPI_INSTR)
    await tb.config_ahb_master.write(0x08, QSPI_INSTR | (1 << 8))
    await wait_for_irq(dut, tb)
    await poll_busy_clear(dut, tb)

    n_clocks = await counter
    tb.log.info("Single-byte SPI PP clock count: observed=%d expected=%d",
                n_clocks, expected)
    assert n_clocks == expected, (
        f"1-byte SPI PP generated {n_clocks} SCLK edges, expected {expected}. "
        f"Excess = DATA_O extra-bit bug. Deficit = counter exit fires too early."
    )


@cocotb.test()
async def test_write_then_read_roundtrip_exact(dut):
    """Write a known pattern, read it back, assert bit-exact match.

    This is the end-to-end canary for silent write corruption. If the
    DATA_O extra-bit bug is present, the flash receives shifted data
    and the readback will not match what was written.
    """
    tb = TB(dut)
    await tb.cycle_reset()
    await SPI_RESET(dut, tb)
    await SPI_WRITE_ENABLE(dut, tb)
    await SPI_CLR_PROTECTION(dut, tb)
    # Chip-erase so prior-test writes at the same address don't AND into
    # our pattern (PP can only flip 1->0).
    await SPI_WRITE_ENABLE(dut, tb)
    await SPI_CHIP_ERASE(dut, tb)
    await SET_QPI_MODE(dut, tb)
    await tb.config_ahb_master.write(0x00, 0x01)

    # Program with a pattern that has non-trivial bit structure
    # (no all-0 or all-1 bytes; any bit shift will produce a visible diff)
    await SPI_WRITE_ENABLE(dut, tb)
    addr = 0x5000
    data = [0xA5A5A5A5, 0x5A5A5A5A, 0xDEADBEEF, 0xCAFEBABE]

    await SPI_WRITE_ENABLE(dut, tb)
    await QPI_PAGE_PROGRAM(dut, tb, addr=addr, words=data, n_words=4)

    await SPI_WRITE_DISABLE(dut, tb)
    rdata = await QPI_READ_WORDS(dut, tb, addr=addr, n_words=4)

    tb.log.info("Round-trip: wrote %s, read %s",
                [hex(x) for x in data], [hex(x) for x in rdata])
    for i in range(4):
        assert rdata[i] == data[i], (
            f"Word {i}: wrote 0x{data[i]:08x}, read 0x{rdata[i]:08x} -- "
            f"DATA_O extra-bit bug corrupts writes"
        )


# ---------------------------------------------------------------------------
# Targeted test for the XiP AHB lockup bug
#
# Background: ahb_qspi_interface.sv has a WAIT_READ state that waits for
# qspi_ready (which depends on AHB_QSPI_ENABLE_ACK and AHB_QSPI_BUSY
# propagating through 2-FF CDC synchronizers). There is no timeout:
#
#     WAIT_READ: if(qspi_ready) next_state = IDLE;
#                else           next_state = WAIT_READ;
#
# HREADYOUT is tied to qspi_ready, so if qspi_ready never asserts, the
# AHB bus stalls indefinitely. On the PYNQ-Z2 board this appears as a
# kernel hang when Python does `mmio.read(0x40000000)`: the AXI-AHB
# bridge blocks, the PS CPU waits for the bus response, interrupts stop
# being serviced, and the network stack dies.
#
# This test demonstrates the hang in simulation by forcing the
# synchronized QSPI_BUSY signal to stay asserted, mimicking what happens
# in hardware when a CDC pulse is lost or the controller's FSM gets
# stuck. It verifies that HREADYOUT never rises within a generous
# window — proving the lockup can occur and measuring how long it
# persists.
#
# Once a timeout-watchdog fix lands in ahb_qspi_interface.sv, this test
# should be updated to assert that HREADYOUT rises with HRESP=ERROR
# within the watchdog period.
# ---------------------------------------------------------------------------


async def _drive_busy_sync_forever(ahb_if, hclk, value=1):
    """Continuously deposit a value onto ahb_qspi_busy_sync every HCLK.

    Needed because .value = X is a deposit that gets overwritten by the
    reg's driver on the next posedge. We re-deposit on every falling edge
    so the value is observed during the following rising edge.
    """
    from cocotb.triggers import FallingEdge
    while True:
        await FallingEdge(hclk)
        ahb_if.ahb_qspi_busy_sync.value = value
        ahb_if.ahb_qspi_busy_meta.value = value


@cocotb.test(timeout_time=500, timeout_unit='us')
async def test_xip_hang_on_stuck_busy(dut):
    """Demonstrate the AHB XiP lockup by forcing the CDC-synchronised BUSY
    signal to stay asserted.

    Models the real-world failure: if AHB_QSPI_ENABLE_ACK is lost in the
    CDC synchroniser (brief pulse drops during the race between HCLK and
    QSPI_SCLK_i), qspi_started never sets, qspi_ready never rises, and
    HREADYOUT stays low forever. The AXI-AHB bridge then hangs, the PS
    CPU blocks on its read, interrupts stop being serviced, and the
    Linux network stack dies — the observed hardware lockup.

    Methodology:
      1. Enable XiP mode (CTRL.XIP_ACTIVE = 1) so the interface routes
         AHB reads to the QSPI controller rather than returning HRESP=ERR.
      2. Spawn a background coroutine that re-deposits
         ahb_qspi_busy_sync=1 every HCLK falling edge. This defeats the
         reg's normal driver and simulates the controller permanently
         appearing busy — the exact condition that causes the hang.
      3. Fire an AHB XiP read in the background; observe HREADY on the
         bus for a window that fits inside cocotbext.ahb's internal
         timeout (5000 HCLK cycles).

    Expected on the current (buggy) RTL: HREADY stays low for every
    cycle after the interface enters WAIT_READ. The test PASSes to
    confirm the bug exists. When the timeout-watchdog fix lands, this
    test will start FAILing — switch to test_xip_timeout_recovery then.
    """
    from cocotb.triggers import RisingEdge, Timer

    tb = TB(dut)
    await tb.cycle_reset()

    await tb.config_ahb_master.write(0x00, 0x00000100)  # XIP_ACTIVE=1
    await tb.config_ahb_master.write(0x30, 0x0000800B)  # FAST_READ + 8 dummy

    ahb_if = dut.u_ahb_qspi_pads.u_top_ahb_qspi.u_ahb_qspi_interface

    # Start the continuous-force coroutine BEFORE issuing the read so the
    # BUSY sync signal is pinned high from the very first WAIT_READ cycle.
    force_task = cocotb.start_soon(
        _drive_busy_sync_forever(ahb_if, dut.HCLK, value=1))

    # Fire the read in the background. cocotbext.ahb times out internally
    # at ~5000 HCLK cycles; we observe within that window.
    read_task = cocotb.start_soon(tb.data_ahb_master.read(0x00, 4))

    # Wait a few cycles for the FSM to actually enter WAIT_READ
    for _ in range(10):
        await RisingEdge(dut.HCLK)

    # Now sample HREADY while the transaction is in-flight. Window must
    # stay under 5000 HCLK to avoid the cocotbext.ahb internal timeout.
    low_cycles = 0
    saw_wait_read = False
    SAMPLES = 2000
    for _ in range(SAMPLES):
        await RisingEdge(dut.HCLK)
        if int(ahb_if.current_state.value) == 1:   # WAIT_READ ordinal
            saw_wait_read = True
        if int(dut.data_HREADY.value) == 0:
            low_cycles += 1

    # Stop continuously-forcing and let the read task die naturally
    force_task.kill()
    ahb_if.ahb_qspi_busy_sync.value = 0
    ahb_if.ahb_qspi_busy_meta.value = 0
    try:
        read_task.kill()
    except Exception:
        pass

    tb.log.info(
        "XiP hang probe: saw_wait_read=%s  HREADY_low_cycles=%d/%d",
        saw_wait_read, low_cycles, SAMPLES)
    assert saw_wait_read, "FSM never entered WAIT_READ — setup failed"

    # With BUSY pinned high, WAIT_READ has no exit. Expect almost every
    # sampled cycle to have HREADY=0. Allow a handful of cycles of slack
    # for the first entry transition.
    assert low_cycles > (SAMPLES - 20), (
        f"HREADY was only low for {low_cycles}/{SAMPLES} cycles "
        f"(>={SAMPLES-20} expected). Either the timeout watchdog is now "
        f"in place (switch to test_xip_timeout_recovery), or the "
        f"continuous-force coroutine didn't pin busy_sync."
    )
    tb.log.info(
        "HANG CONFIRMED: data_HREADY stayed low for %d of %d HCLK cycles "
        "with ahb_qspi_busy_sync pinned high. Without a watchdog in "
        "ahb_qspi_interface.sv, the AHB bus wedges indefinitely — "
        "exactly what happens on the PYNQ-Z2 board during xip_torture.",
        low_cycles, SAMPLES)


@cocotb.test(timeout_time=2000, timeout_unit='us')
async def test_xip_timeout_recovery(dut):
    """Verify the AHB interface recovers cleanly when BUSY is stuck.

    This test EXPECTS the timeout watchdog in ahb_qspi_interface.sv.
    With the fix in place, a stuck BUSY signal should cause the FSM to
    transition to ERR, raise HRESP=1 with HREADYOUT=1 for one cycle, and
    then return to IDLE.

    Methodology:
      1. Continuously force ahb_qspi_busy_sync=1 via a background
         coroutine (defeating the reg's normal driver every HCLK).
      2. Start an AHB XiP read.
      3. Sample the interface FSM state every HCLK, looking for an ERR
         state visit — this is the evidence the watchdog fired.
      4. Also observe the HRESP pulse while state=ERR.

    Without the fix: FSM never leaves WAIT_READ, test fails with
    "watchdog never fired" after the timeout_time.

    With the fix: FSM transitions WAIT_READ -> ERR -> IDLE; test observes
    the ERR state at least once and asserts HRESP=1 during that cycle.
    """
    from cocotb.triggers import RisingEdge

    tb = TB(dut)
    await tb.cycle_reset()

    await tb.config_ahb_master.write(0x00, 0x00000100)  # XIP_ACTIVE=1
    await tb.config_ahb_master.write(0x30, 0x0000800B)

    ahb_if = dut.u_ahb_qspi_pads.u_top_ahb_qspi.u_ahb_qspi_interface

    # Start the continuous-force BEFORE the read task
    force_task = cocotb.start_soon(
        _drive_busy_sync_forever(ahb_if, dut.HCLK, value=1))

    read_task = cocotb.start_soon(tb.data_ahb_master.read(0x00, 4))

    # Watch for the FSM to enter ERR state (the watchdog has fired).
    # The cocotb testbench overrides WATCHDOG_WIDTH=12 on ahb_qspi_pads
    # so the watchdog fires at 4096 HCLK (~41 us at 50 MHz), keeping the
    # test inside cocotbext.ahb's 5000-cycle master timeout. Production
    # default is 16 bits (~1.3 ms) — giving headroom for CLK_DIV=31 on PS.
    WATCHDOG_MAX_HCLK = 4900
    saw_err = False
    hresp_during_err = 0
    for cycle in range(WATCHDOG_MAX_HCLK):
        await RisingEdge(dut.HCLK)
        state = int(ahb_if.current_state.value)
        if state == 2:   # ERR
            saw_err = True
            hresp_during_err = int(dut.data_HRESP.value)
            tb.log.info("Watchdog FIRED at cycle %d: state=ERR, HRESP=%d",
                        cycle, hresp_during_err)
            break

    # Clean up forcing so we can exit cleanly
    force_task.kill()
    ahb_if.ahb_qspi_busy_sync.value = 0
    ahb_if.ahb_qspi_busy_meta.value = 0
    # The read_task has likely raised its own timeout exception by now —
    # kill() silently to suppress it, then drain any pending exception.
    try:
        read_task.kill()
    except Exception:
        pass
    # Give asyncio one more tick to clean up the background tasks'
    # exceptions so they don't leak into the next test
    from cocotb.triggers import Timer as _T
    await _T(1, 'ns')

    assert saw_err, (
        f"Watchdog never fired within {WATCHDOG_MAX_HCLK} HCLK cycles. "
        "The FSM never entered ERR state. Either the watchdog fix is not "
        "in place, or its counter is too wide for this test.")
    assert hresp_during_err == 1, (
        f"Saw ERR state but HRESP was {hresp_during_err}, expected 1. "
        "The error response path is broken.")
    tb.log.info("RECOVERY CONFIRMED: watchdog fires, FSM exits to ERR "
                "with HRESP=1, AHB bus is released. Kernel hang avoided.")


# ---------------------------------------------------------------------------
# CDC regression tests
#
# These target specific bugs identified in the QSPI controller's clock
# domain crossings. See /home/dam1n19/.claude/plans/qspi-cdc-analysis.md
# for the full report.
# ---------------------------------------------------------------------------


@cocotb.test()
async def test_cdc_control_bus_metastability(dut):
    """Bug A: HCLK -> QSPI_SCLK_i control bus has no synchroniser.

    The controller synchronises only QSPI_ENABLE. All other control
    signals (CMD, READ, WRITE, ADDR_EN, N_RW_BYTES, ADDR, QIO_MODE, ...)
    are read raw from the HCLK domain. The design relies on software
    holding these stable before ENABLE is asserted.

    This test verifies that convention by attempting to corrupt
    N_RW_BYTES IMMEDIATELY after the ENABLE write. If the controller
    latches the pre-ENABLE value, the transaction completes with the
    intended byte count. If it latches the post-ENABLE value, we see a
    mismatched data-phase length.

    Expected: PASS on current RTL (the two-write pattern plus natural
    APB latency gives the control bus enough time to stabilise before
    the 2-cycle ENABLE sync resolves).

    Regression trigger: if someone adds an APB write optimisation that
    collapses the two-write pattern, or if bus timing drifts.
    """
    tb = TB(dut)
    await tb.cycle_reset()
    await SPI_RESET(dut, tb)
    await SPI_WRITE_ENABLE(dut, tb)
    await SPI_CLR_PROTECTION(dut, tb)
    # Chip-erase so prior-test writes at the same address don't AND into
    # our pattern (PP can only flip 1->0).
    await SPI_WRITE_ENABLE(dut, tb)
    await SPI_CHIP_ERASE(dut, tb)

    # Program a known pattern to a known address in SPI mode
    await tb.config_ahb_master.write(0x00, 0x00)  # SPI mode
    await SPI_WRITE_ENABLE(dut, tb)
    addr = 0x7000
    data = [0xCC33CC33]
    await tb.config_ahb_master.write(0x0C, addr)
    await tb.config_ahb_master.write(0x20, data[0])

    # Configure PP with N_RW=3 (4 bytes)
    QSPI_INSTR_4B = 0x02 | (1 << 10) | (1 << 11) | (3 << 16)
    await tb.config_ahb_master.write(0x08, QSPI_INSTR_4B)

    # Trigger the transaction with ENABLE
    await tb.config_ahb_master.write(0x08, QSPI_INSTR_4B | (1 << 8))  # ENABLE
    # Wait for the FSM to have left IDLE (so control-bus latching has fired).
    # At CLK_DIV=5, QSPI_enable_sync rises ~20 HCLK cycles after the write,
    # and the latch captures on that same cycle. 40 HCLK gives margin.
    from cocotb.triggers import Timer as _T
    await _T(400, 'ns')   # ~40 HCLK at 100 MHz sim clock
    # Now corrupt N_RW_BYTES mid-transaction. With the Bug A fix in place,
    # the controller uses the value latched at IDLE->OP transition and
    # ignores this write. Without the fix, the FSM picks up the new value.
    QSPI_INSTR_16B = 0x02 | (1 << 10) | (1 << 11) | (15 << 16)
    await tb.config_ahb_master.write(0x08, QSPI_INSTR_16B | (1 << 8))

    await wait_for_irq(dut, tb)
    await poll_busy_clear(dut, tb)

    # Wait for flash internal program
    for _ in range(10000):
        sr = await SPI_READ_STAT_REG(dut, tb)
        if not (sr & (1 << 24)):
            break
        await Timer(time=1, units='us')

    await SPI_WRITE_DISABLE(dut, tb)
    rdata = await SPI_READ_WORDS(dut, tb, addr=addr, n_words=4)

    # First word must match. Subsequent words must be erased (0xFFFFFFFF).
    # If the race caused a 16-byte PP, subsequent words would contain
    # whatever happened to be in WDATA1/2/3 (which is zeros).
    tb.log.info("Control-bus race: wrote data[0]=0x%08x, read %s",
                data[0], [hex(x) for x in rdata])
    assert rdata[0] == data[0], f"Word 0 mismatch: {rdata[0]:#x} vs {data[0]:#x}"
    for i in range(1, 4):
        assert rdata[i] == 0xFFFFFFFF, (
            f"Word {i} = {rdata[i]:#010x}, expected 0xFFFFFFFF. "
            f"The race corrupted N_RW_BYTES and the PP wrote too many "
            f"bytes — the HCLK control bus needs synchronisation.")


@cocotb.test()
async def test_cdc_rdata_stability_at_low_clkdiv(dut):
    """Bug C: QSPI_RDATA crosses QSPI_SCLK_i -> HCLK with no sync.

    The 128-bit RDATA bus relies on BUSY acting as a valid qualifier —
    BUSY must drop only after RDATA has been stable for enough cycles
    for the interface to latch it safely. At CLK_DIV=1 (QSPI_SCLK_i =
    HCLK/2), the stability window is tight.

    This test sweeps CLK_DIV from 5 down to 1, does write/read cycles
    at each, and checks for data corruption.
    """
    tb = TB(dut)
    await tb.cycle_reset()
    await SPI_RESET(dut, tb)
    await SPI_WRITE_ENABLE(dut, tb)
    await SPI_CLR_PROTECTION(dut, tb)
    # Chip-erase so prior-test writes at the same address don't AND into
    # our pattern (PP can only flip 1->0).
    await SPI_WRITE_ENABLE(dut, tb)
    await SPI_CHIP_ERASE(dut, tb)

    # Pre-program a sector of known data at CLK_DIV=5 (safe)
    await tb.config_ahb_master.write(0x34, 5)
    addr = 0x8000
    pattern = [0xDEADBEEF, 0xCAFEBABE, 0x12345678, 0x87654321]
    await SET_QPI_MODE(dut, tb)
    await tb.config_ahb_master.write(0x00, 0x01)
    await SPI_WRITE_ENABLE(dut, tb)
    await QPI_PAGE_PROGRAM(dut, tb, addr=addr, words=pattern, n_words=4)
    await SPI_WRITE_DISABLE(dut, tb)

    # Now sweep CLK_DIV from 5 down to 2 and verify readback
    for clk_div in [5, 4, 3, 2]:
        await tb.config_ahb_master.write(0x34, clk_div)
        rdata = await QPI_READ_WORDS(dut, tb, addr=addr, n_words=4)
        tb.log.info("CLK_DIV=%d: read %s", clk_div, [hex(x) for x in rdata])
        for i, expected in enumerate(pattern):
            assert rdata[i] == expected, (
                f"CLK_DIV={clk_div} word {i}: read 0x{rdata[i]:08x}, "
                f"expected 0x{expected:08x}. RDATA stability window "
                f"may be violated at this CLK_DIV.")

    # Return to safe CLK_DIV
    await tb.config_ahb_master.write(0x34, 5)


@cocotb.test(timeout_time=2000, timeout_unit='us')
async def test_cdc_ack_retry_after_watchdog(dut):
    """Bug D: verify the system can recover from a watchdog firing.

    After a hung XiP read triggers the watchdog, subsequent XiP reads
    must still work. If the controller's internal FSM got wedged by the
    failure that triggered the watchdog, it might still be stuck — and
    a second read would hang the same way.
    """
    from cocotb.triggers import RisingEdge

    tb = TB(dut)
    await tb.cycle_reset()
    # The flash model is not reset with the IP: a previous test can leave it
    # in QPI mode, and then step 3's SPI FAST_READ returns X. This used to be
    # masked because step 3 completed from the stale ACK of step 1 without a
    # fetch (H-PIPE assessment item c, fixed in ahb_qspi_interface.sv).
    # Put the flash back in SPI mode first, as the other tests do.
    await SPI_RESET(dut, tb)
    await tb.config_ahb_master.write(0x00, 0x00000100)  # XIP_ACTIVE=1
    await tb.config_ahb_master.write(0x30, 0x0000800B)  # FAST_READ + 8 dummy

    ahb_if = dut.u_ahb_qspi_pads.u_top_ahb_qspi.u_ahb_qspi_interface

    # Step 1: induce a hang via forced busy_sync, verify watchdog fires
    force_task = cocotb.start_soon(
        _drive_busy_sync_forever(ahb_if, dut.HCLK, value=1))
    read_task = cocotb.start_soon(tb.data_ahb_master.read(0x00, 4))

    saw_err = False
    for _ in range(4900):
        await RisingEdge(dut.HCLK)
        if int(ahb_if.current_state.value) == 2:
            saw_err = True
            break

    force_task.kill()
    ahb_if.ahb_qspi_busy_sync.value = 0
    ahb_if.ahb_qspi_busy_meta.value = 0
    try:
        read_task.kill()
    except Exception:
        pass

    assert saw_err, "Watchdog didn't fire in step 1 — baseline broken"
    tb.log.info("Step 1: watchdog fired as expected")

    # Step 2: wait for the FSM to return to IDLE
    for _ in range(100):
        await RisingEdge(dut.HCLK)
        if int(ahb_if.current_state.value) == 0:
            break
    assert int(ahb_if.current_state.value) == 0, "FSM didn't return to IDLE"

    # Step 3: now issue a fresh XiP read. If the controller's internal
    # state is still sane, this should complete normally (possibly with
    # garbage data — we don't care about the value, only that it doesn't
    # hang again).
    tb.log.info("Step 3: issuing fresh XiP read after watchdog recovery")
    try:
        _ = await tb.data_ahb_master.read(0x10, 4)
        tb.log.info("RECOVERY VERIFIED: second XiP read completed after "
                    "watchdog fired. System is resilient.")
    except Exception as exc:
        assert False, (
            f"Second XiP read failed after watchdog recovery: {exc}. "
            f"The controller's internal FSM is wedged — watchdog needs "
            f"to reset the controller too, not just the AHB interface.")


# ============================================================================
# Regression: CG092 cache handles back-to-back NSEQ SINGLE reads correctly.
#
# Originally written as a bug-repro for the nanosoc-ethernet-flash-system
# stage-0 symptom where a DMA-230 copy from the XIP aperture into IMEM
# self-clears CHNL_ENABLE_SET (PL230 reports "done") but leaves IMEM at X.
# A variant of the same stage-0 that copies via CPU loads through the XIP
# aperture (no DMA) copies correctly — so the bug is somehow DMA-230-
# master-specific, not a cache-slave-port flaw.
#
# Hypothesis this test was designed to probe
# ------------------------------------------
# PL230's AHB master is specified to issue exactly: HBURST=SINGLE,
# HTRANS ∈ {IDLE, NONSEQ}, HSIZE=byte/halfword/word, HPROT[0]=1 (verified
# via pl230_udma.v assertions PL230_E03/E05/E06 and the hard-coded
# `assign hburst = 3'b000` at pl230_ahb_ctrl.v:1038). The Cortex-M0+
# issues the same shape for individual LDRs, so burst/size/prot can't be
# the differentiator. The remaining candidate was *transaction phasing*:
# PL230 issues the next NSEQ on the HCLK edge after HREADY rises with
# zero IDLE cycles between transactions (the M0+ naturally inserts
# pipeline gaps). cocotbext.ahb's AHBLiteMaster.read(..., pip=True)
# emits that exact pattern (see cocotbext/ahb/ahb_master.py
# _create_vector, pip branch: address vector is [ADDR_0, ADDR_1, ...,
# DEFAULT], no IDLE between).
#
# Outcome: this hypothesis is REFUTED
# -----------------------------------
# Running this test against the cache (as of 3e9ef16 on feat-nanosoc_int)
# PASSES for both the sequential control block and the pipelined REPRO
# block. The cache handles zero-IDLE NSEQ-NSEQ-... correctly when driven
# by cocotbext.ahb at the ahb_qspi IP boundary.
#
# Implication: the nanoSoC DMA-master-port bug is NOT in the cache core's
# handling of back-to-back NSEQs. Remaining candidates (in order):
#   a) Interconnect routing: something on the nanoSoC eth_flash_interconnect
#      path from dma_230_0_m_* into qspi_flash_0's data port pipelines or
#      re-samples a signal that the direct AHB master path does not.
#   b) PL230-specific signal combos: HPROT[3:1] / HMASTLOCK / (unconnected
#      HMASTER) bit values that differ from AHBLiteMaster defaults and
#      happen to matter to the cache core.
#   c) CPU-concurrent APB traffic: in nanoSoC, the CPU polls
#      CHNL_ENABLE_SET via the interconnect + DMA APB while the DMA
#      master is reading through the cache. The cache's APB port and AHB
#      slave port are on the same APB/AHB mux — arbitration interactions
#      might only manifest with two in-flight masters.
#
# This test is kept as a positive regression (so if someone ever breaks the
# back-to-back NSEQ path in the cache, we catch it cleanly). A DMA-specific
# repro would need a PL230 instance inside ahb_qspi_cocotb.v — see the
# comment at the end of this test.
# ============================================================================


async def _program_flash_region(dut, tb, *, base_addr, words):
    """Program `words` into flash at `base_addr` via QPI_PAGE_PROGRAM.

    QPI_PAGE_PROGRAM writes at most 4 words per call (the APB regs only
    have 4 RWDATA slots). Assumes the caller has already run `init_qpi`
    (reset + enter QPI + set QIO_MODE + write-enable + clear-protection).
    Loops in 4-word chunks.
    """
    CHUNK = 4
    for i in range(0, len(words), CHUNK):
        chunk = words[i:i + CHUNK]
        await SPI_WRITE_ENABLE(dut, tb)
        await QPI_PAGE_PROGRAM(dut, tb, addr=base_addr + i * 4,
                               words=chunk, n_words=len(chunk))
        await SPI_WRITE_DISABLE(dut, tb)
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
