SoC-Labs/AHB-QSPI/uvm/ahb_qspi/tests/ahb_qspi_xip_test.sv

///////////////////////////////////////////////////////////////////////////////
// ahb_qspi_xip_test.sv
///////////////////////////////////////////////////////////////////////////////
// XIP (execute-in-place) tests via AHB data port.
///////////////////////////////////////////////////////////////////////////////

`ifndef GUARD_AHB_QSPI_XIP_TEST_SV
`define GUARD_AHB_QSPI_XIP_TEST_SV

class ahb_qspi_xip_test extends ahb_qspi_base_test;

  `uvm_component_utils(ahb_qspi_xip_test)

  function new(string name = "ahb_qspi_xip_test", uvm_component parent = null);
    super.new(name, parent);
  endfunction

  virtual task run_phase(uvm_phase phase);
    qspi_init_sequence init_seq;
    qspi_cmd_sequence  cmd;
    bit [31:0] read_data;

    phase.raise_objection(this);
    wait_for_reset();

    // Initialise flash and program known data
    init_seq = qspi_init_sequence::type_id::create("init");
    init_seq.clear_protect = 1;
    init_seq.start(env.apb_agt.sequencer);

    // Program a page of data at address 0
    begin
      // WREN
      cmd = qspi_cmd_sequence::type_id::create("wren");
      cmd.opcode = SPI_OP_WREN;
      cmd.start(env.apb_agt.sequencer);

      // Page Program with test pattern
      cmd = qspi_cmd_sequence::type_id::create("pp");
      cmd.opcode     = SPI_OP_PP;
      cmd.do_write   = 1;
      cmd.addr_en    = 1;
      cmd.flash_addr = 22'h0;
      cmd.n_rw_bytes = 15;  // 16 bytes
      cmd.wdata[0]   = 32'hAABBCCDD;
      cmd.wdata[1]   = 32'h11223344;
      cmd.wdata[2]   = 32'h55667788;
      cmd.wdata[3]   = 32'h99AABBCC;
      cmd.start(env.apb_agt.sequencer);

      // Wait for flash programming to complete
      begin
        bit flash_busy = 1;
        int timeout = 1000;
        while (flash_busy && timeout > 0) begin
          cmd = qspi_cmd_sequence::type_id::create("poll_sr");
          cmd.opcode     = SPI_OP_RDSR;
          cmd.do_read    = 1;
          cmd.n_rw_bytes = 1;
          cmd.start(env.apb_agt.sequencer);
          flash_busy = cmd.rdata[0][0];
          timeout--;
        end
      end
    end

    `uvm_info("XIP_TEST", "Flash programmed, starting XIP reads", UVM_LOW)

    // Configure AHB interface
    apb_write(QSPI_AHB_SETUP_ADDR, {16'h0, 4'h8, 4'h0, SPI_OP_FAST_READ});

    // Enable XIP mode
    apb_write(QSPI_CTRL_ADDR, (1 << CTRL_XIP_ACTIVE_BIT));
    wait_clks(5);

    // Perform AHB reads using base test helper
    for (int i = 0; i < 8; i++) begin
      ahb_read(i * 4, read_data);
      `uvm_info("XIP_TEST", $sformatf("AHB READ [0x%06h] = 0x%08h", i*4, read_data), UVM_LOW)
    end

    // Disable XIP
    apb_write(QSPI_CTRL_ADDR, 32'h0);

    `uvm_info("XIP_TEST", "XIP test complete", UVM_LOW)
    phase.drop_objection(this);
  endtask

endclass

`endif // GUARD_AHB_QSPI_XIP_TEST_SV
